westonb/cute-qcw/README.md

# cute-qcw
A compact qcw tesla coil system with a FPGA based controller. System design and construction are in progress. Build photos viewable here: https://www.flickr.com/photos/63341195@N08/sets/72157678478822788/
