westonb/cute-qcw/schematic/controller.pdf

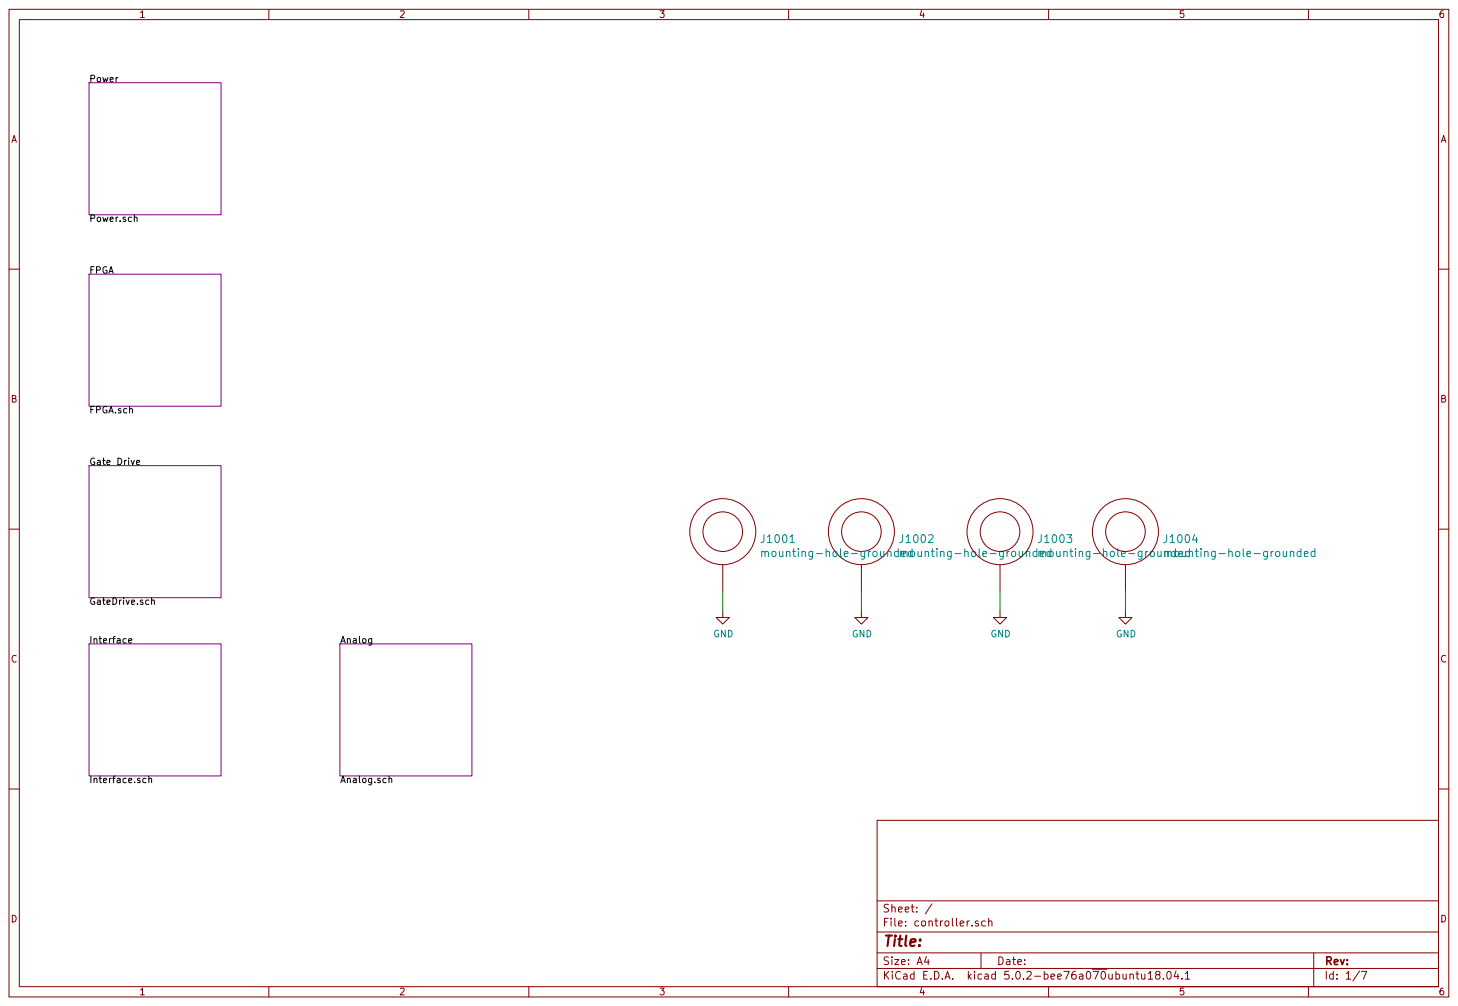
[picture p1: page 1]

Power Power.sch FPGA

FPGA.sch Gate Drive GateDrive.sch

Id: 1/7 Title: File: controller.sch Sheet: /

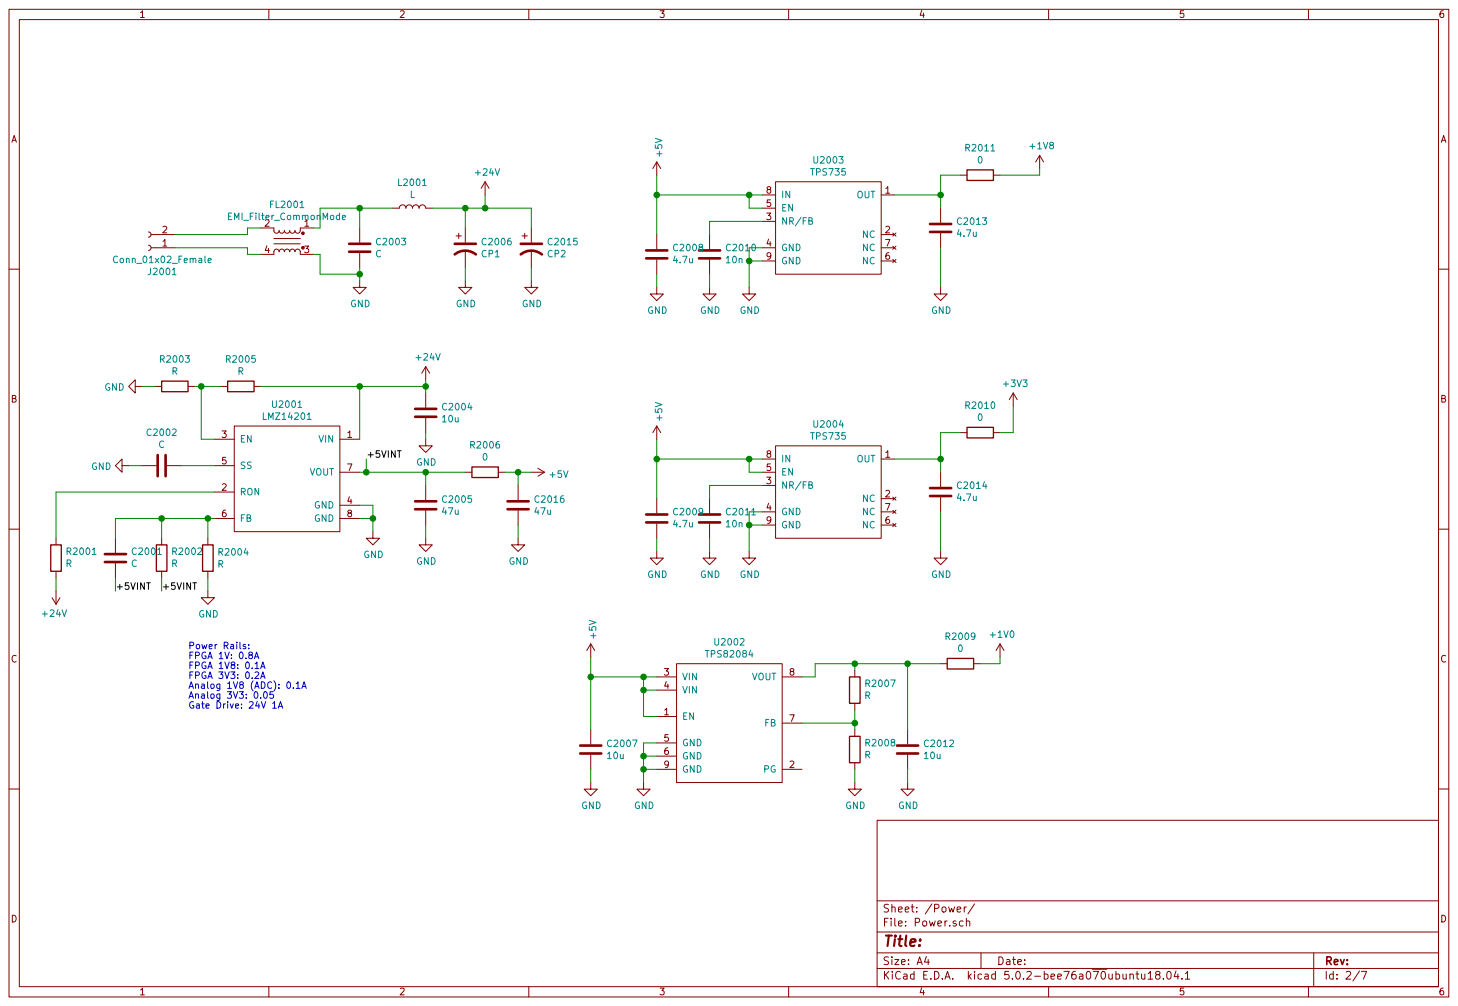
[picture p2: page 2]

Id: 2/7 Title: File: Power.sch Sheet: /Power/

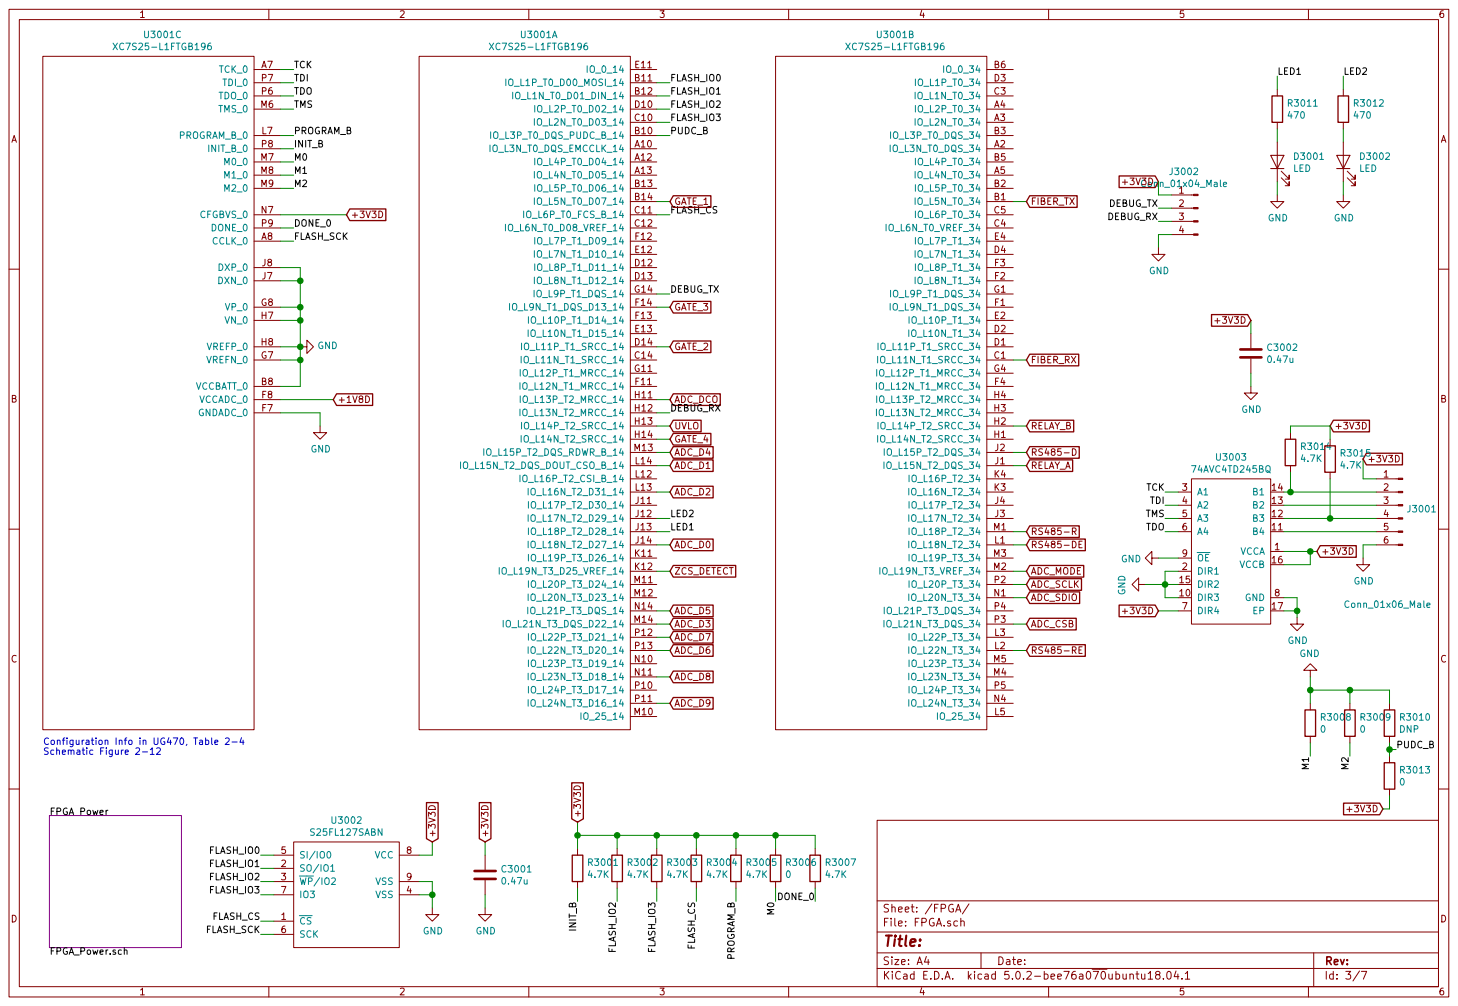
[picture p3: page 3]

Configuration Info in UG470, Table 2-4

Id: 3/7 Title: File: FPGA.sch Sheet: /FPGA/ FPGA Power FPGA_Power.sch

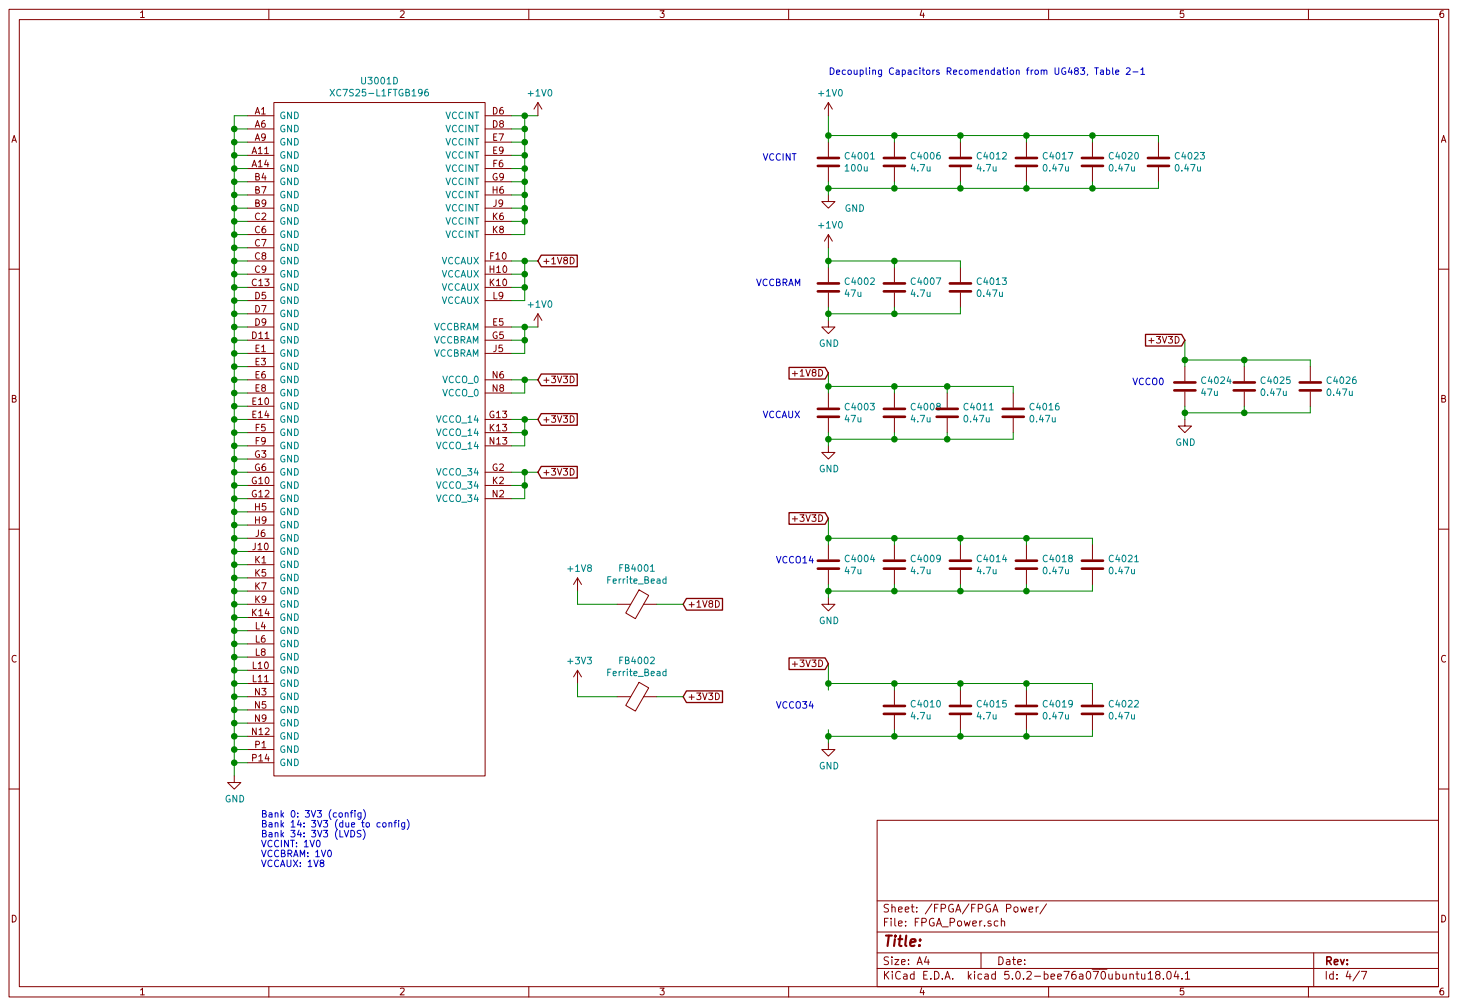
[picture p4: page 4]

Bank 14: 3V3 (due to config)
Bank 34: 3V3 (LVDS) VCCINT: 1V0 VCCBRAM: 1V0 VCCAUX: 1V8

File: FPGA_Power.sch Sheet: /FPGA/FPGA Power/

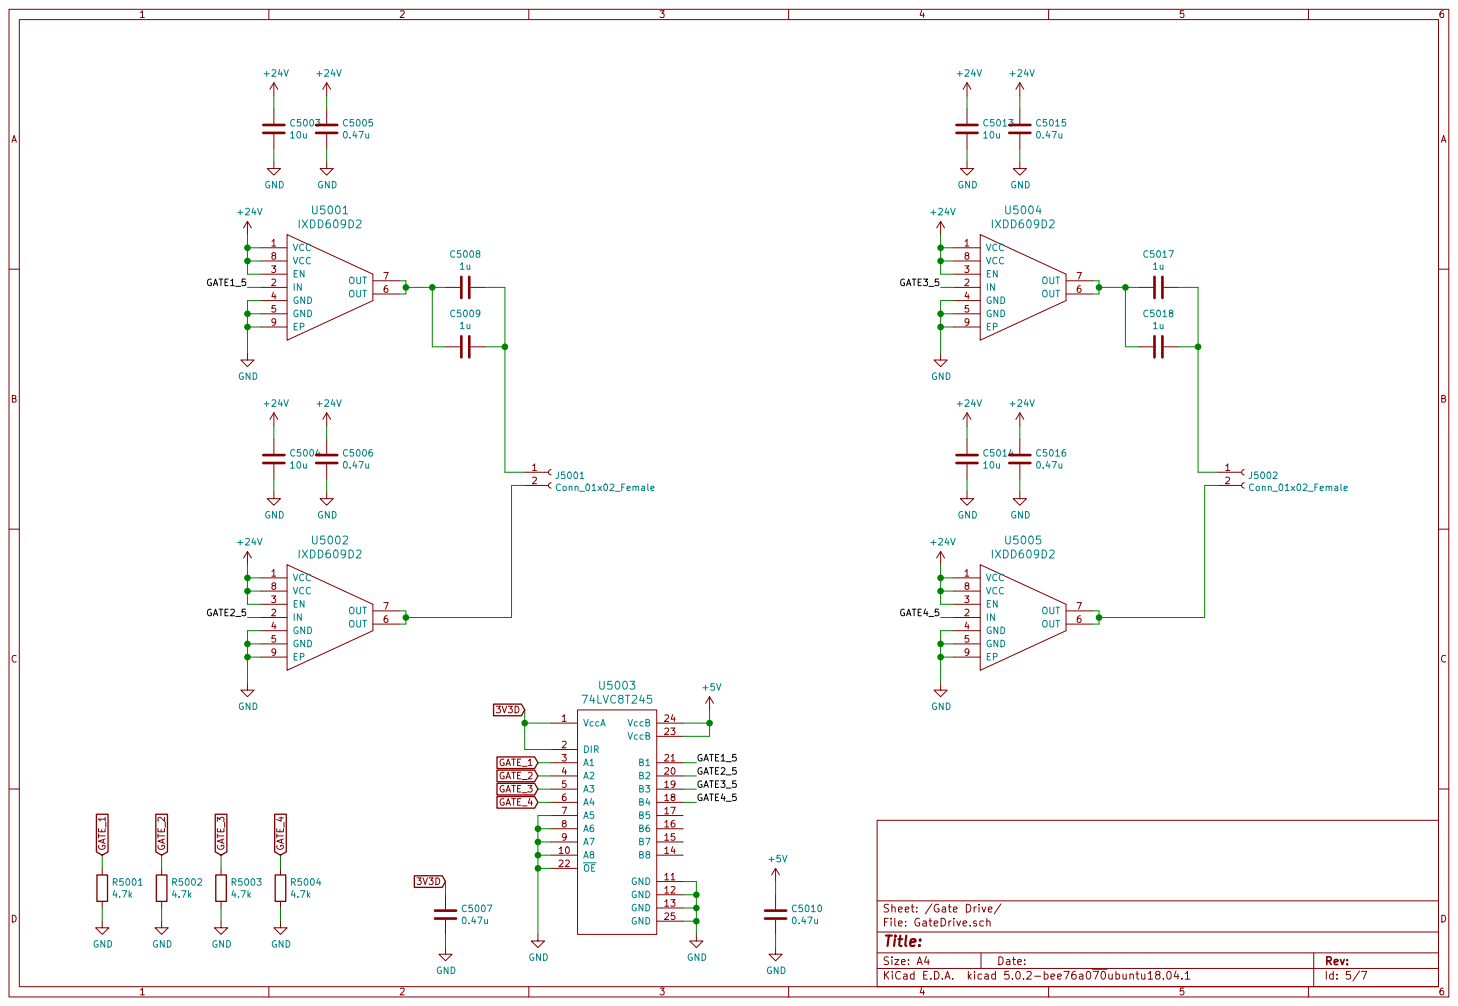
[picture p5: page 5]

Id: 5/7 Title: File: GateDrive.sch Sheet: /Gate Drive/

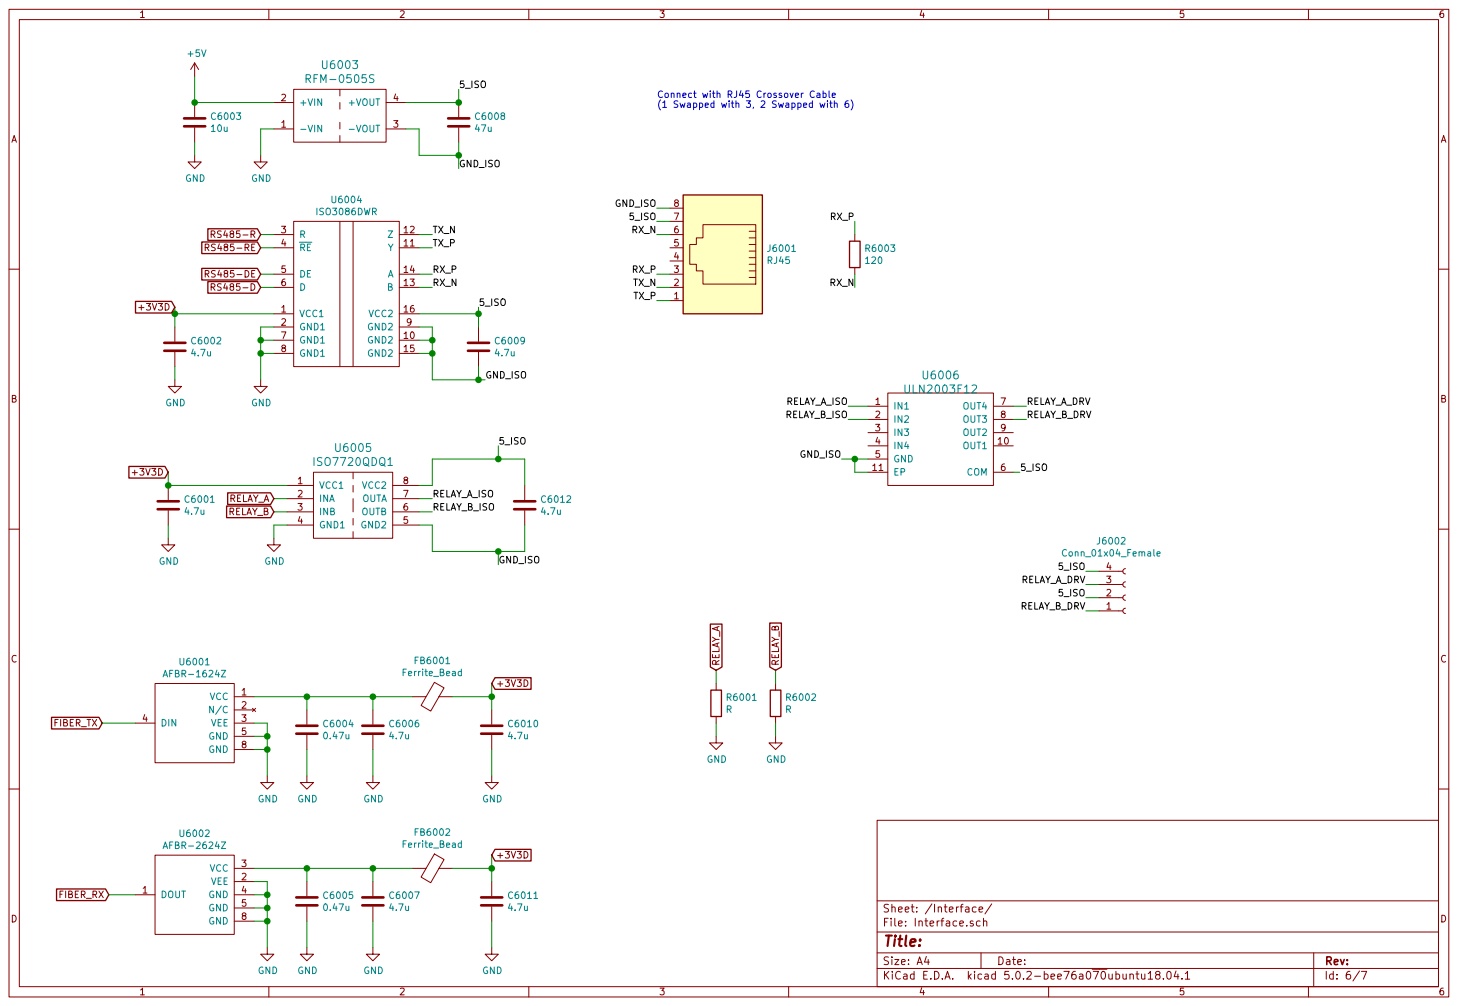
[picture p6: page 6]

J6002 Conn_01x04_Female Connect with RJ45 Crossover Cable
(1 Swapped with 3, 2 Swapped with 6) TX_P

Id: 6/7 Title: File: Interface.sch Sheet: /Interface/

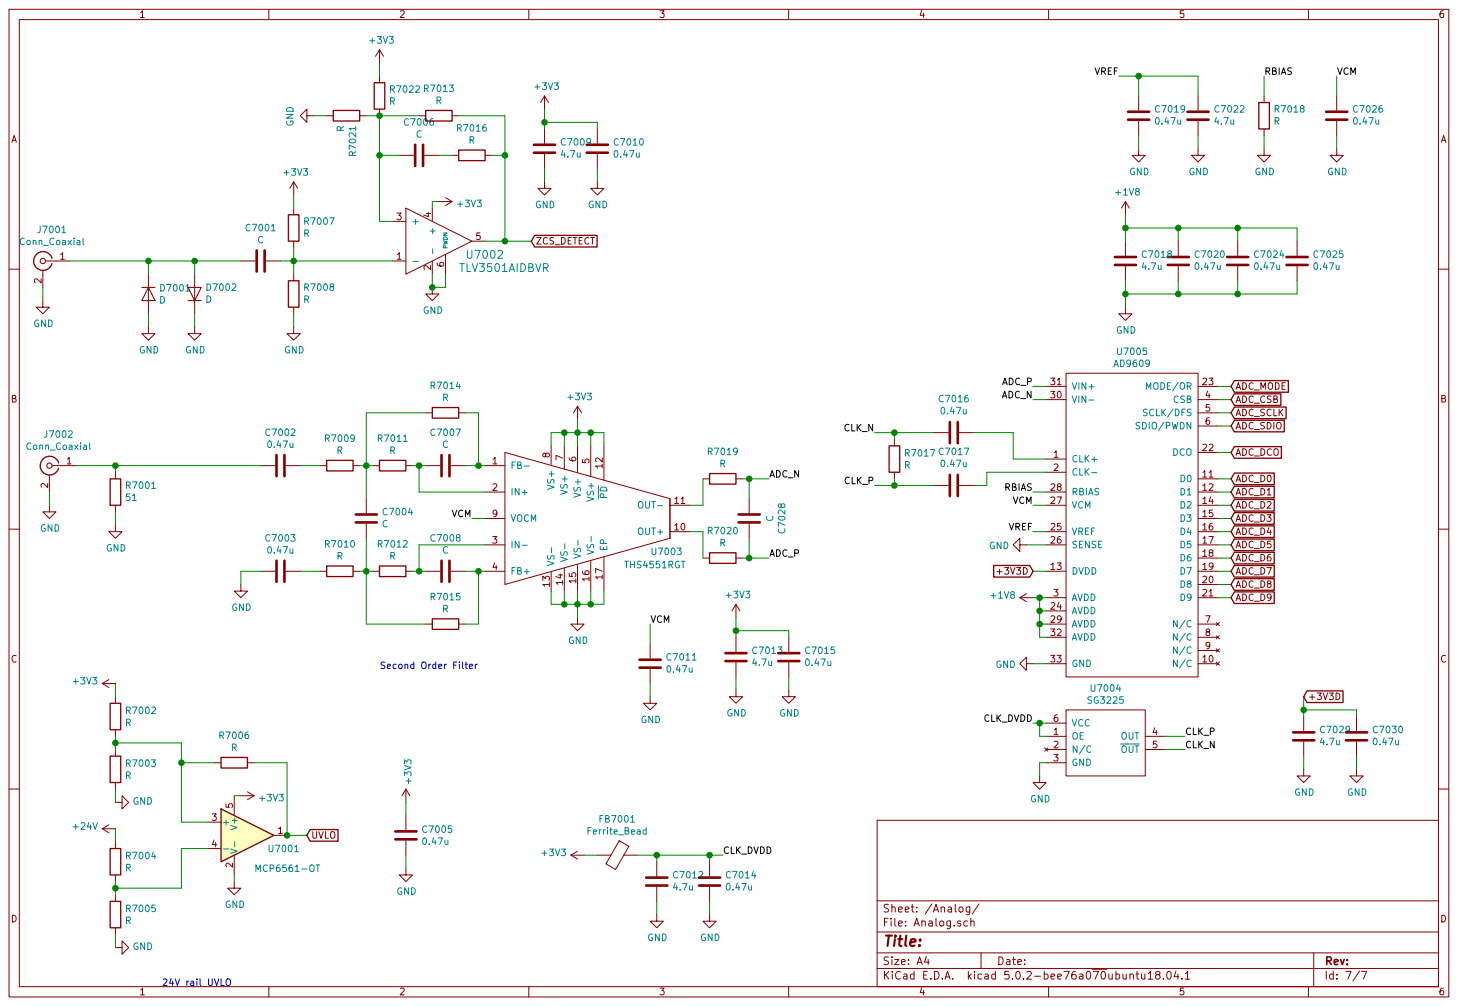
[picture p7: page 7]
