westonb/cute-qcw/schematic/mmc.pdf

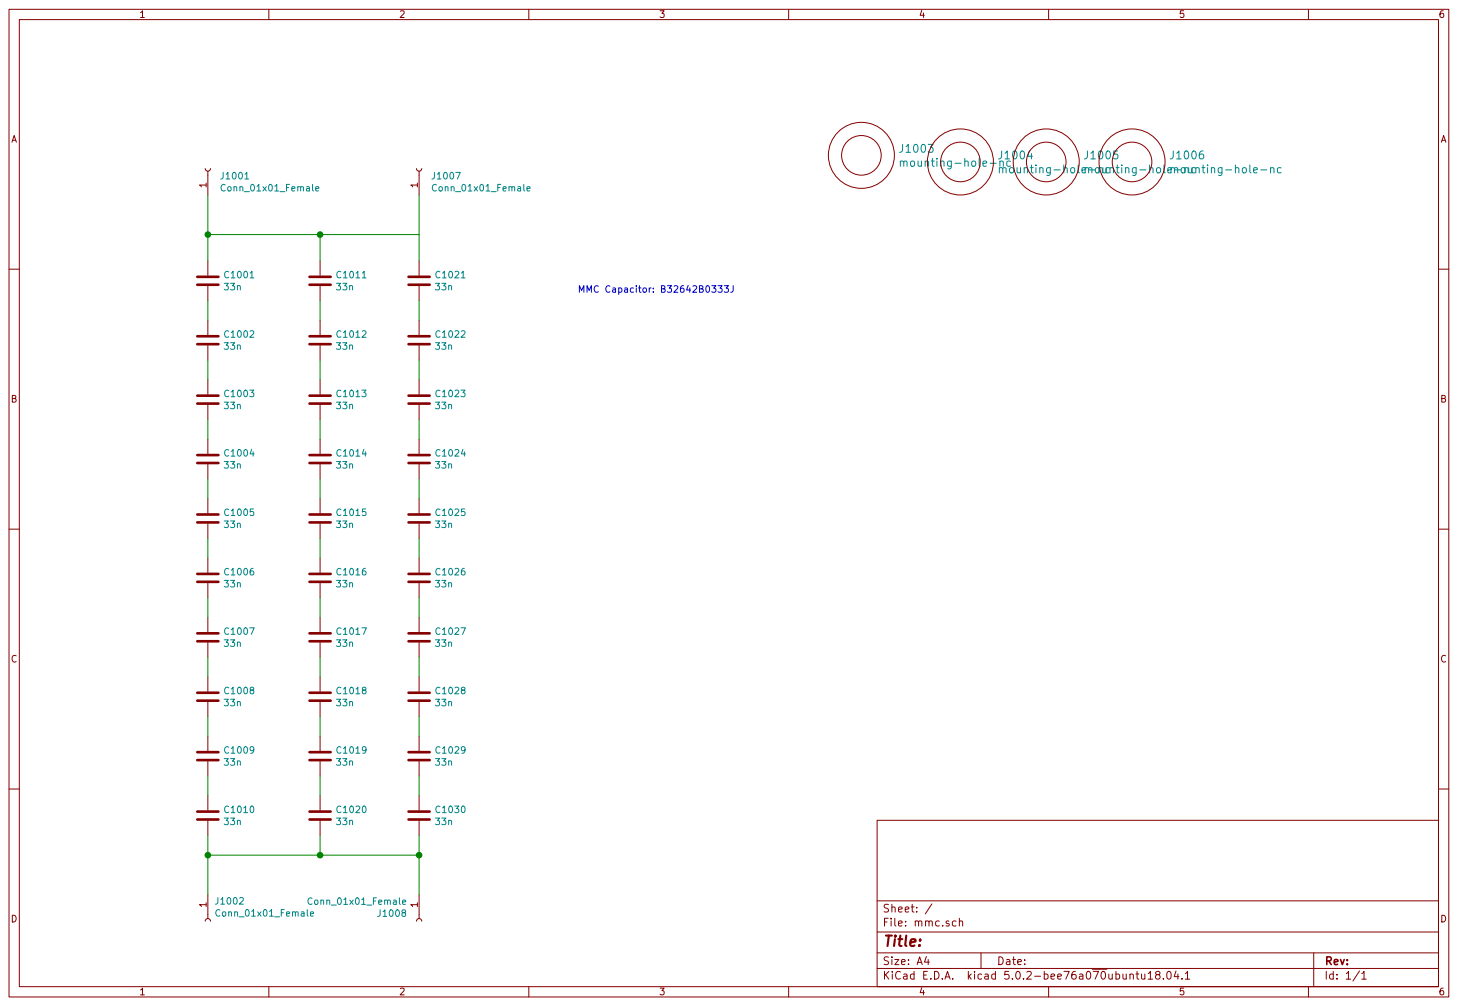
[picture p8: page 1]

J1003 mounting-hole-nc J1004 mounting-hole-nc

Id: 1/1 Title: File: mmc.sch Sheet: /
