westonb/cute-qcw/schematic/power.pdf

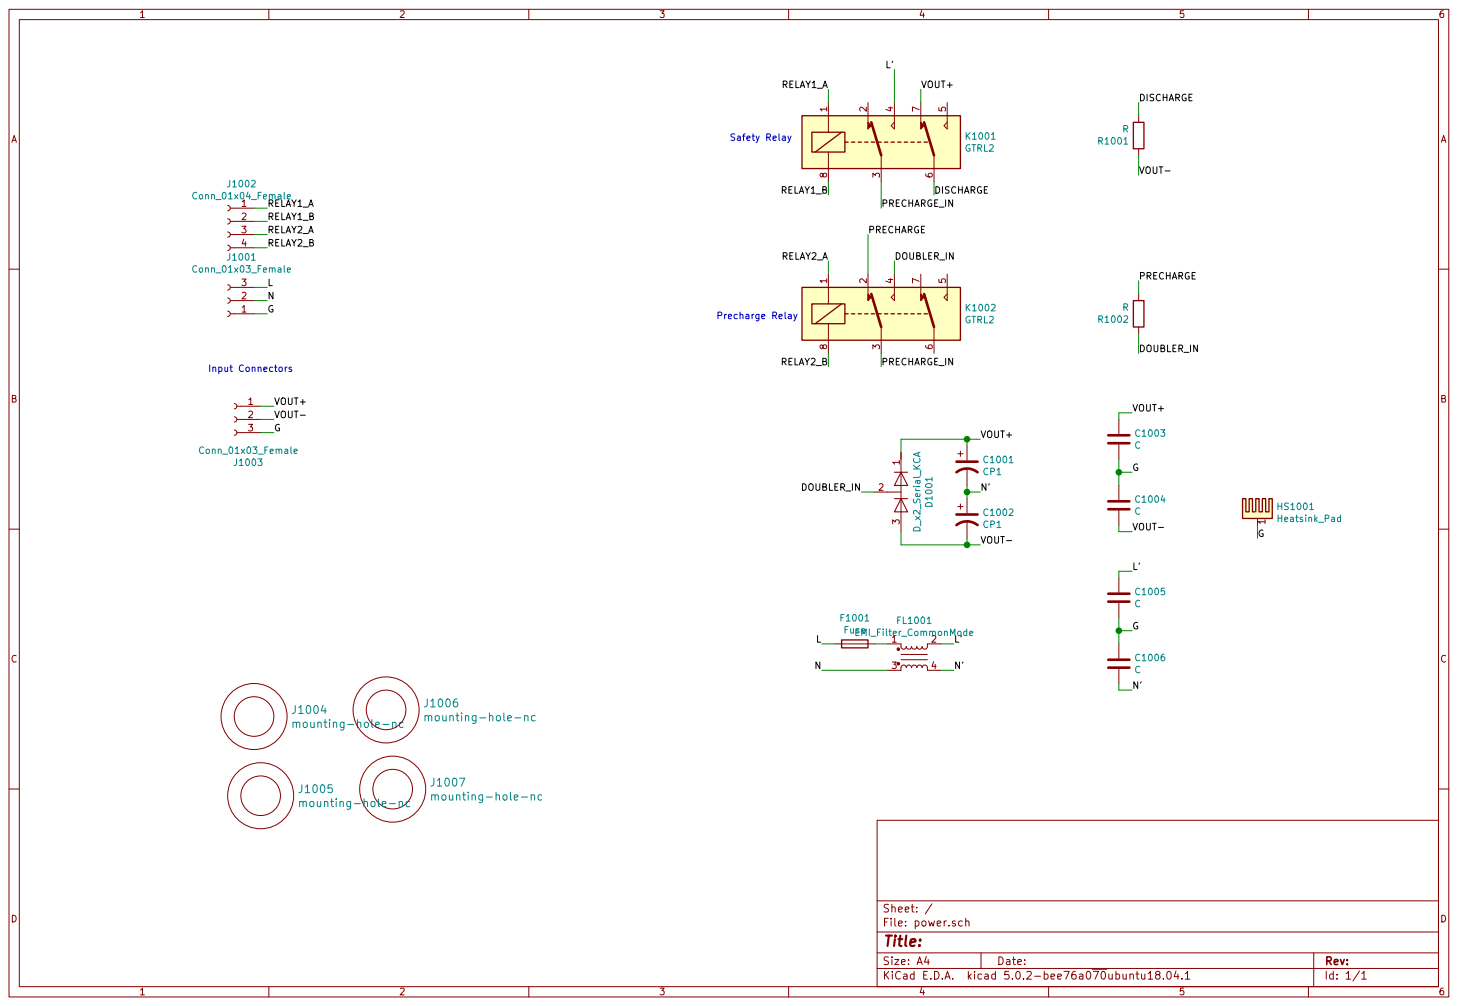
[picture p9: page 1]

File: power.sch Sheet: /
Id: 1/1 Title:
