westonb/cute-qcw/schematic/inverter.pdf

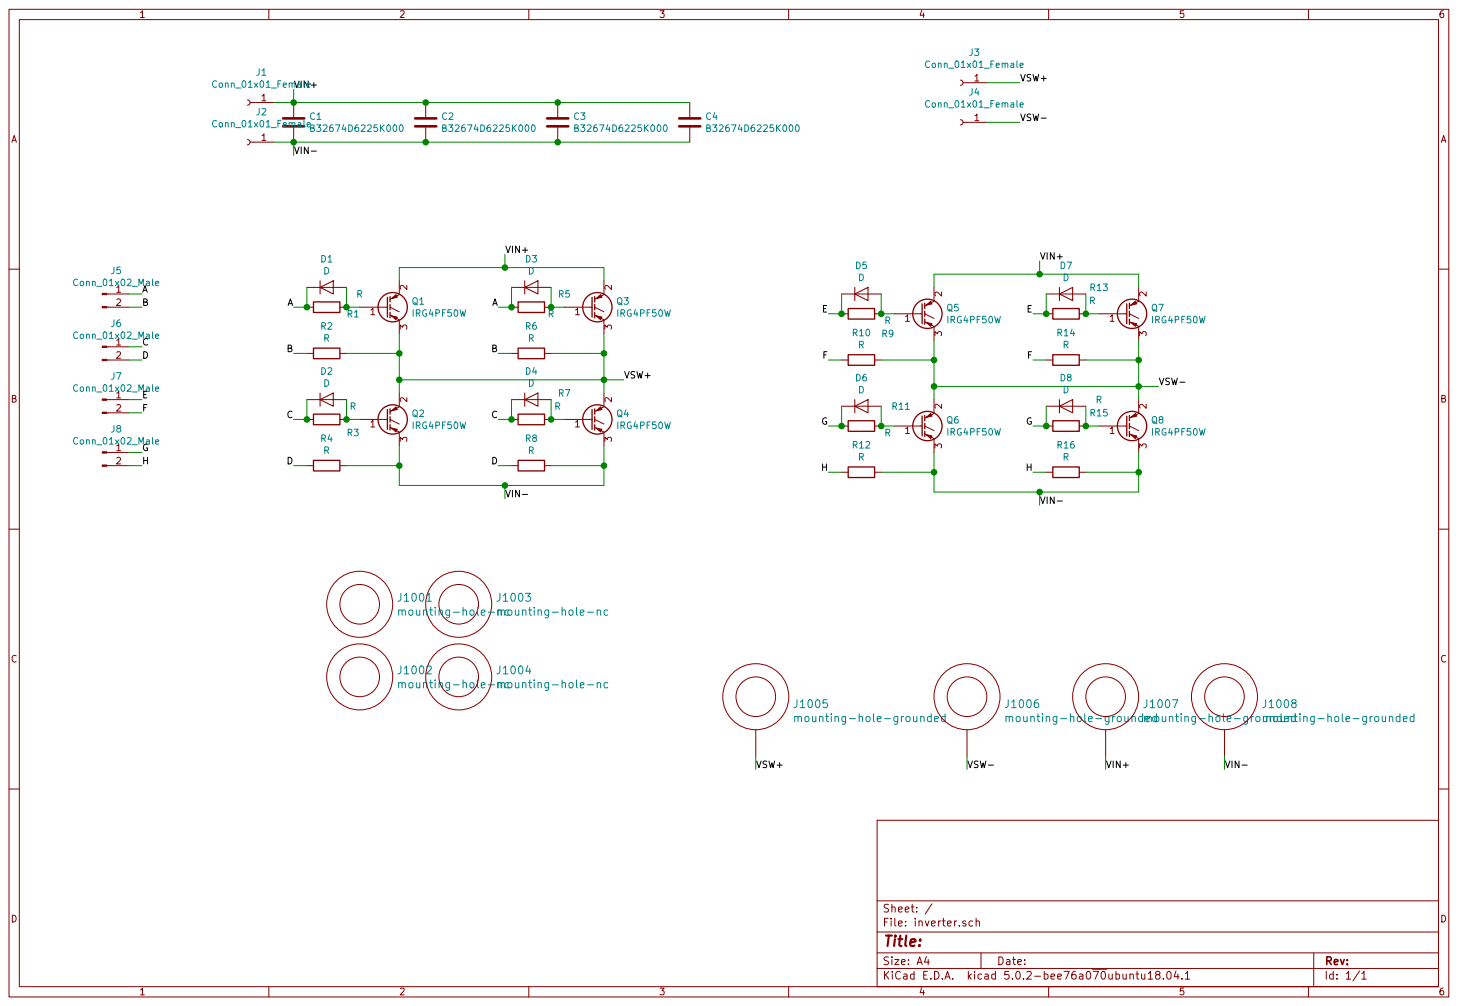
[picture p10: page 1]

Id: 1/1 Title: File: inverter.sch Sheet: /
