westonb/cute-qcw/simulation/inverter.asc

C1: cap; 3.3µ; Rser=12.4m Lser=21n
C2: cap; 3.3µ; Rser=12.4m Lser=21n
C3: cap; 4.7µ
C4: cap; 3.3µ; Rser=12.4m Lser=21n
C5: cap; 3.3µ; Rser=12.4m Lser=21n
C6: cap; 4.7µ
C7: cap; 10n
L1: ind; 1n
L2: ind; 1n
L3: ind; 1n
L4: ind; 1n
L5: ind2; 20µ
L6: ind2; 20µ
L7: ind; 1n
L8: ind; 1n
L9: ind; 1n
L10: ind; 1n
L11: ind; 1n
L12: ind2; 20µ
L13: ind; 1n
L14: ind; 1n
L15: ind; 1n
L16: ind; 1n
L17: ind2; 20µ
L18: ind2; 20µ
L19: ind; 1n
L20: ind; 1n
L21: ind; 1n
L22: ind; 1n
L23: ind; 1n
L24: ind2; 20µ
L25: ind; 1n
L26: ind; 1n
L27: ind; 15.8µ
R1: res; 0.5
R2: res; 0.5
R3: res; 0.5
R4: res; 0.5
R5: res; 0.5
R6: res; 0.5
R7: res; 0.5
R8: res; 0.5
R9: res; 0.1
R10: res; 0.5
R11: res; 0.5
R12: res; 0.5
R13: res; 0.5
R14: res; 0.5
R15: res; 0.5
R16: res; 0.5
R17: res; 0.5
R18: res; 0.1
R19: res; 2.5
U1: FGA40T65UQDF_3P
U2: FGA40T65UQDF_3P
U3: FGA40T65UQDF_3P
U4: FGA40T65UQDF_3P
U5: FGA40T65UQDF_3P
U6: FGA40T65UQDF_3P
U7: FGA40T65UQDF_3P
U8: FGA40T65UQDF_3P
V1: voltage; PULSE(0 16 0 10n 10n {PERIOD*DUTY} {PERIOD})
V2: voltage; PULSE(0 16 {0.5*PERIOD} 10n 10n {PERIOD*DUTY} {PERIOD})
V3: voltage; PULSE(0 16 {PHASE*PERIOD/360} 10n 10n {PERIOD*DUTY} {PERIOD})
V4: voltage; PULSE(0 16 {PHASE*PERIOD/360+0.5*PERIOD} 10n 10n {PERIOD*DUTY} {PERIOD})
V5: voltage; 200; Rser=0.5
Named nets: 0, GD_1A, GD_1B, GD_2A, GD_2B, GD_3A, GD_3B, GD_4A, GD_4B, OUT_A, OUT_B
K1 L5 L6 L12 1
.param FREQ 400E3
.param PERIOD {1/FREQ}
.param DUTY=0.45
.param PHASE=90
K2 L24 L17 L18 1
.tran 0 {200*PERIOD} 0
,LIB ONSEMI_IGBT_FS4FGA40T65UQDF_REV0fe2_ltspice.txt
.ic V(n003) = 200
.ic V(n002) = 200
.ic V(n004) = 200
.ic V(n005) = 200
