westonb/cute-qcw/simulation/inverter_mismatch.asc

C1: cap; 400p; Rser=500m
C2: cap; 400p; Rser=500m
C3: cap; 400p; Rser=500m
C4: cap; 400p; Rser=500m
C5: cap; 400p; Rser=500m
C6: cap; 400p; Rser=500m
C7: cap; 9.9n
D1: diode; D_PWR
D2: diode; D_PWR
D3: diode; D_PWR
D4: diode; D_PWR
D5: diode; D_PWR
D6: diode; D_PWR
L1: ind; 10n; Rser=10m
L2: ind; 100n
L3: ind; 10n; Rser=10m
L4: ind; 10n; Rser=10m
L5: ind; 10n; Rser=10m
L6: ind; 100n
L10: ind; {L11}
L11: ind; {l12}
L12: ind; {l13}
L13: ind2; {l23}
L14: ind2; 1
L15: ind2; 1
L16: ind2; {1*n3*n3}
L17: ind2; {1*n2*n2}
L18: ind; 10n; Rser=10m
L19: ind; 10n; Rser=10m
L20: ind; 100n
L27: ind; 15.8µ
R19: res; 2.5
S1: sw; SW_PWR
S2: sw; SW_PWR
S3: sw; SW_PWR
S4: sw; SW_PWR
S5: sw; SW_PWR
S6: sw; SW_PWR
V1: voltage; PULSE(-20 20 {1.5*PERIOD+MISMATCH} {TRISE} {TFALL} {PERIOD*DUTY} {PERIOD})
V2: voltage; PULSE(-20 20 {PERIOD} {TRISE} {TFALL} {PERIOD*DUTY} {PERIOD})
V3: voltage; PULSE(-20 20 {PERIOD} {TRISE} {TFALL} {PERIOD*DUTY} {PERIOD})
V4: voltage; PULSE(-20 20 {PERIOD+MISMATCH} {TRISE} {TFALL} {PERIOD*DUTY} {PERIOD})
V5: voltage; PULSE(-20 20 {1.5*PERIOD} {TRISE} {TFALL} {PERIOD*DUTY} {PERIOD})
V6: voltage; PULSE(-20 20 {1.5*PERIOD} {TRISE} {TFALL} {PERIOD*DUTY} {PERIOD})
V7: voltage; 200; Rser=0.01
V8: voltage; 200; Rser=0.01
V9: voltage; 200; Rser=0.01
Named nets: 0, VSW1, VSW2, 1A, 1B, 2A, 2B, 3A, 3B
.param FREQ 400E3
.param PERIOD {1/FREQ}
.param DUTY=0.45
.param TFALL 40n
.param TRISE 40n
.param MISMATCH=0.1n
.tran 0 {20*PERIOD} {PERIOD}
.model SW_PWR SW(Ron = 0.05 Roff=1Meg Vt=0 Vh=-10)
.model D_PWR D(Ron=10m Roff=1Meg Vfwd=0.7)m
.param L11 5.4E-6
.param n2 {5.1E-6/L11}
.param n3 {2.6E-7/L11}
.param l12 {1/(1*n2*11039)}
.param l13 {1/(1*n3*19890)}
.param l23 {-1/(n2*n3*11039)}
K1 L14 L17 1
K2 L15 L16 1
