westonb/cute-qcw/pcb/controller/controller.kicad_pcb

## KiCad design pcb/controller/controller.kicad_pcb (2019-02-12)

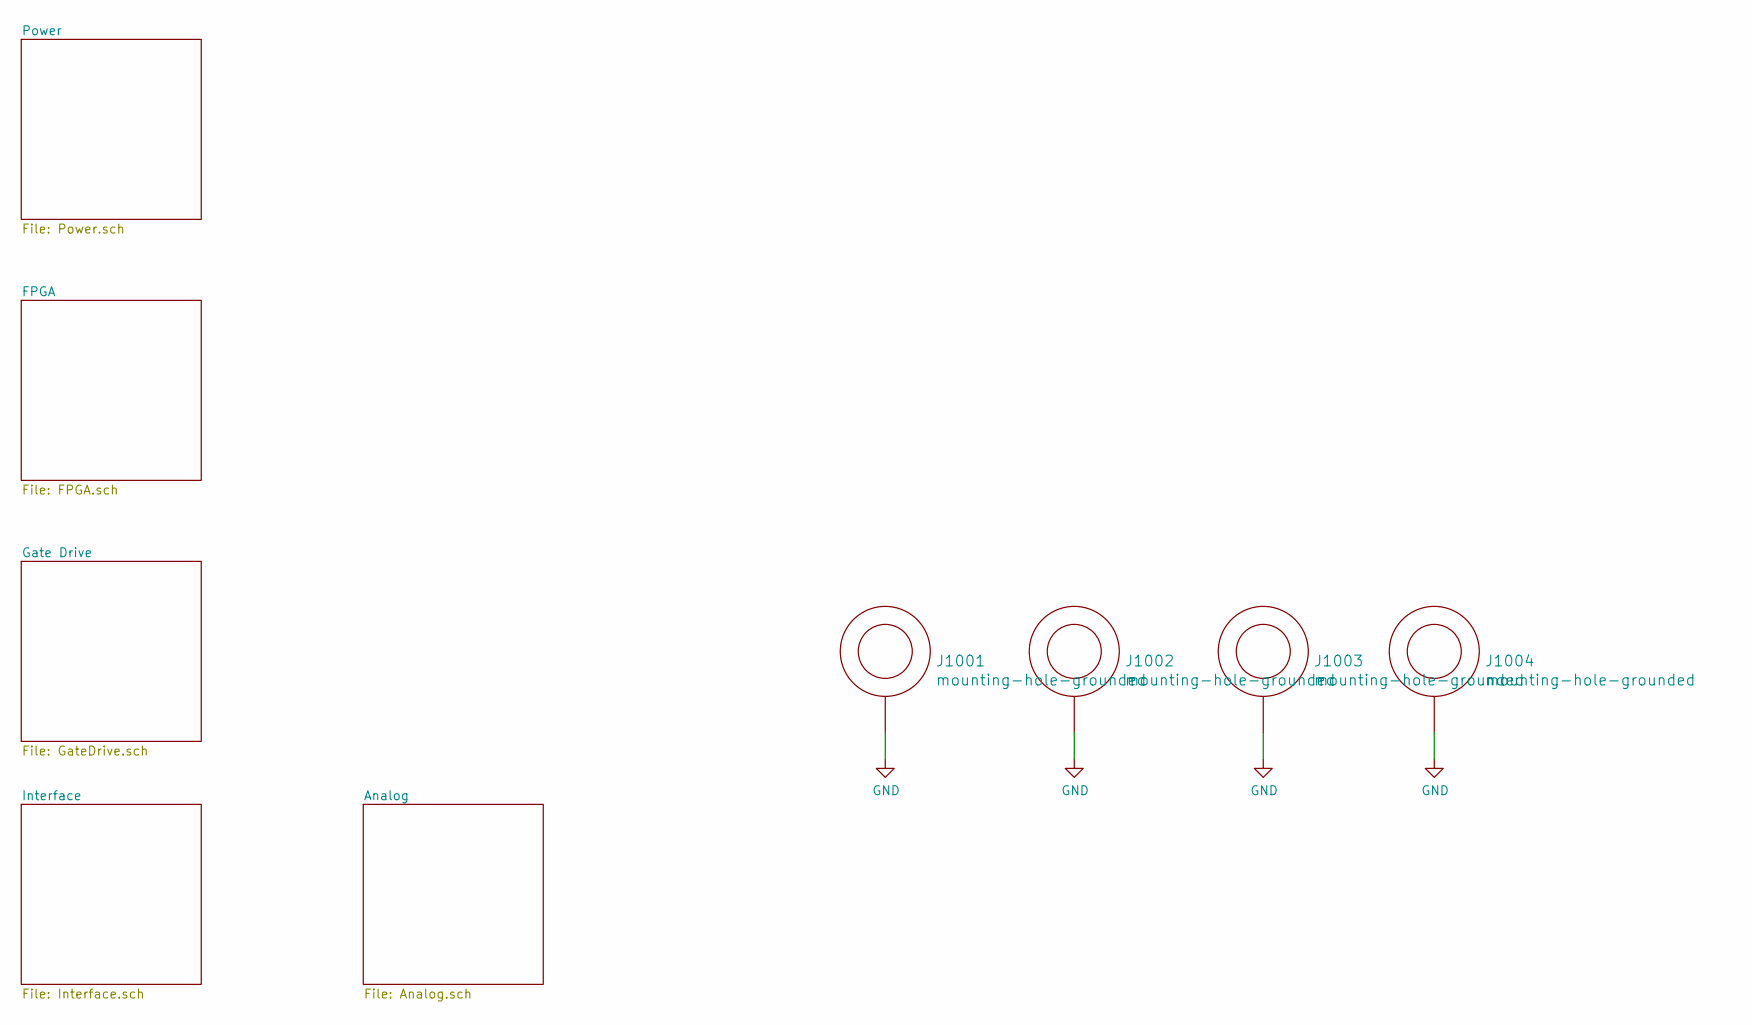
[picture p11: schematic controller.sch]

Parts:
J1001, J1002, J1003, J1004: mounting-hole-grounded; M3-tight-fit-pan-head

Connections:
GND: J1001.1, J1002.1, J1003.1, J1004.1; also elsewhere on the board

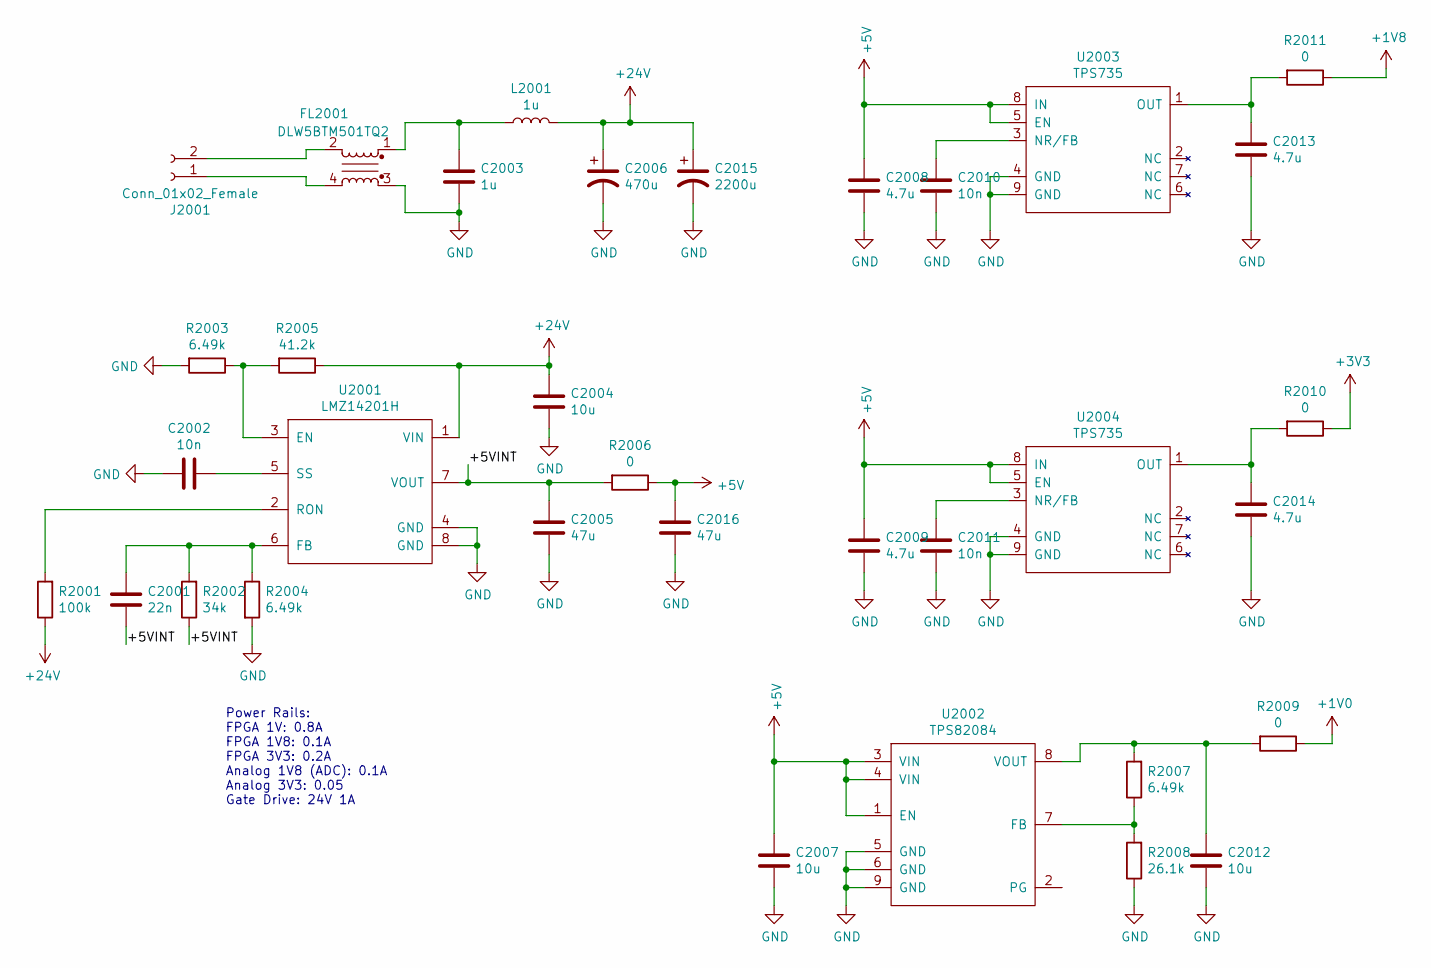
[picture p12: schematic Power.sch]

Parts:
C2001: 22n; C_0402_1005Metric
C2002, C2010, C2011: 10n; C_0402_1005Metric
C2003: 1u; C_0805_2012Metric
C2004: 10u; C_1206_3216Metric
C2005, C2016: 47u; C_0805_2012Metric
C2006: 470u; CP_Radial_D10.0mm_P5.00mm
C2007, C2012: 10u; C_0805_2012Metric
C2008, C2009, C2013, C2014: 4.7u; C_0402_1005Metric
C2015: 2200u; CAP_16mmx37mm_horizontal
FL2001: DLW5BTM501TQ2; DLW5BTM
J2001: Conn_01x02_Female; Terminal-block-plug_2x1_3.5mm-pitch
L2001: 1u; L_Vishay_IHLP-1212
R2001: 100k; R_0402_1005Metric
R2002: 34k; R_0402_1005Metric
R2003, R2004, R2007: 6.49k; R_0402_1005Metric
R2005: 41.2k; R_0402_1005Metric
R2006, R2009, R2010, R2011: 0; R_0805_2012Metric
R2008: 26.1k; R_0402_1005Metric
U2001: LMZ14201H; TO-PMOD-7
U2002: TPS82084; uSil-8
U2003, U2004: TPS735; SON-8_EP

Connections:
+1V0: R2009.1; also elsewhere on the board
+1V8: R2011.1; also elsewhere on the board
+3V3: R2010.1; also elsewhere on the board
+5V: C2007.1, C2008.2, C2009.2, C2016.1, R2006.1, U2002.1 (EN), U2002.3 (VIN), U2002.4 (VIN), U2003.5 (EN), U2003.8 (IN), U2004.5 (EN), U2004.8 (IN); also elsewhere on the board
+24V: C2004.1, C2006.1, C2015.1, L2001.2, R2001.1, R2005.1, U2001.1 (VIN); also elsewhere on the board
/Power/+5VINT: C2001.1, C2005.1, R2002.1, R2006.2, U2001.7 (VOUT)
GND: C2002.2, C2003.2, C2004.2, C2005.2, C2006.2, C2007.2, C2008.1, C2009.1, C2010.1, C2011.1, C2012.2, C2013.1, C2014.1, C2015.2, C2016.2, FL2001.3, R2003.2, R2004.2, R2008.1, U2001.4 (GND), U2001.8 (GND), U2002.5 (GND), U2002.6 (GND), U2002.9 (GND), U2003.4 (GND), U2003.9 (GND), U2004.4 (GND), U2004.9 (GND); also elsewhere on the board
unnamed: C2001.2, R2002.2, R2004.1, U2001.6 (FB)
unnamed: C2002.1, U2001.5 (SS)
unnamed: C2003.1, FL2001.1, L2001.1
unnamed: C2010.2, U2003.3 (NR/FB)
unnamed: C2011.2, U2004.3 (NR/FB)
unnamed: C2012.1, R2007.2, R2009.2, U2002.8 (VOUT)
unnamed: C2013.2, R2011.2, U2003.1 (OUT)
unnamed: C2014.2, R2010.2, U2004.1 (OUT)
unnamed: FL2001.2, J2001.2
unnamed: FL2001.4, J2001.1
unnamed: R2001.2, U2001.2 (RON)
unnamed: R2003.1, R2005.2, U2001.3 (EN)
unnamed: R2007.1, R2008.2, U2002.7 (FB)

Notes on the sheet:
Power Rails: FPGA 1V: 0.8A FPGA 1V8: 0.1A FPGA 3V3: 0.2A Analog 1V8 (ADC): 0.1A Analog 3V3: 0.05 Gate Drive: 24V 1A

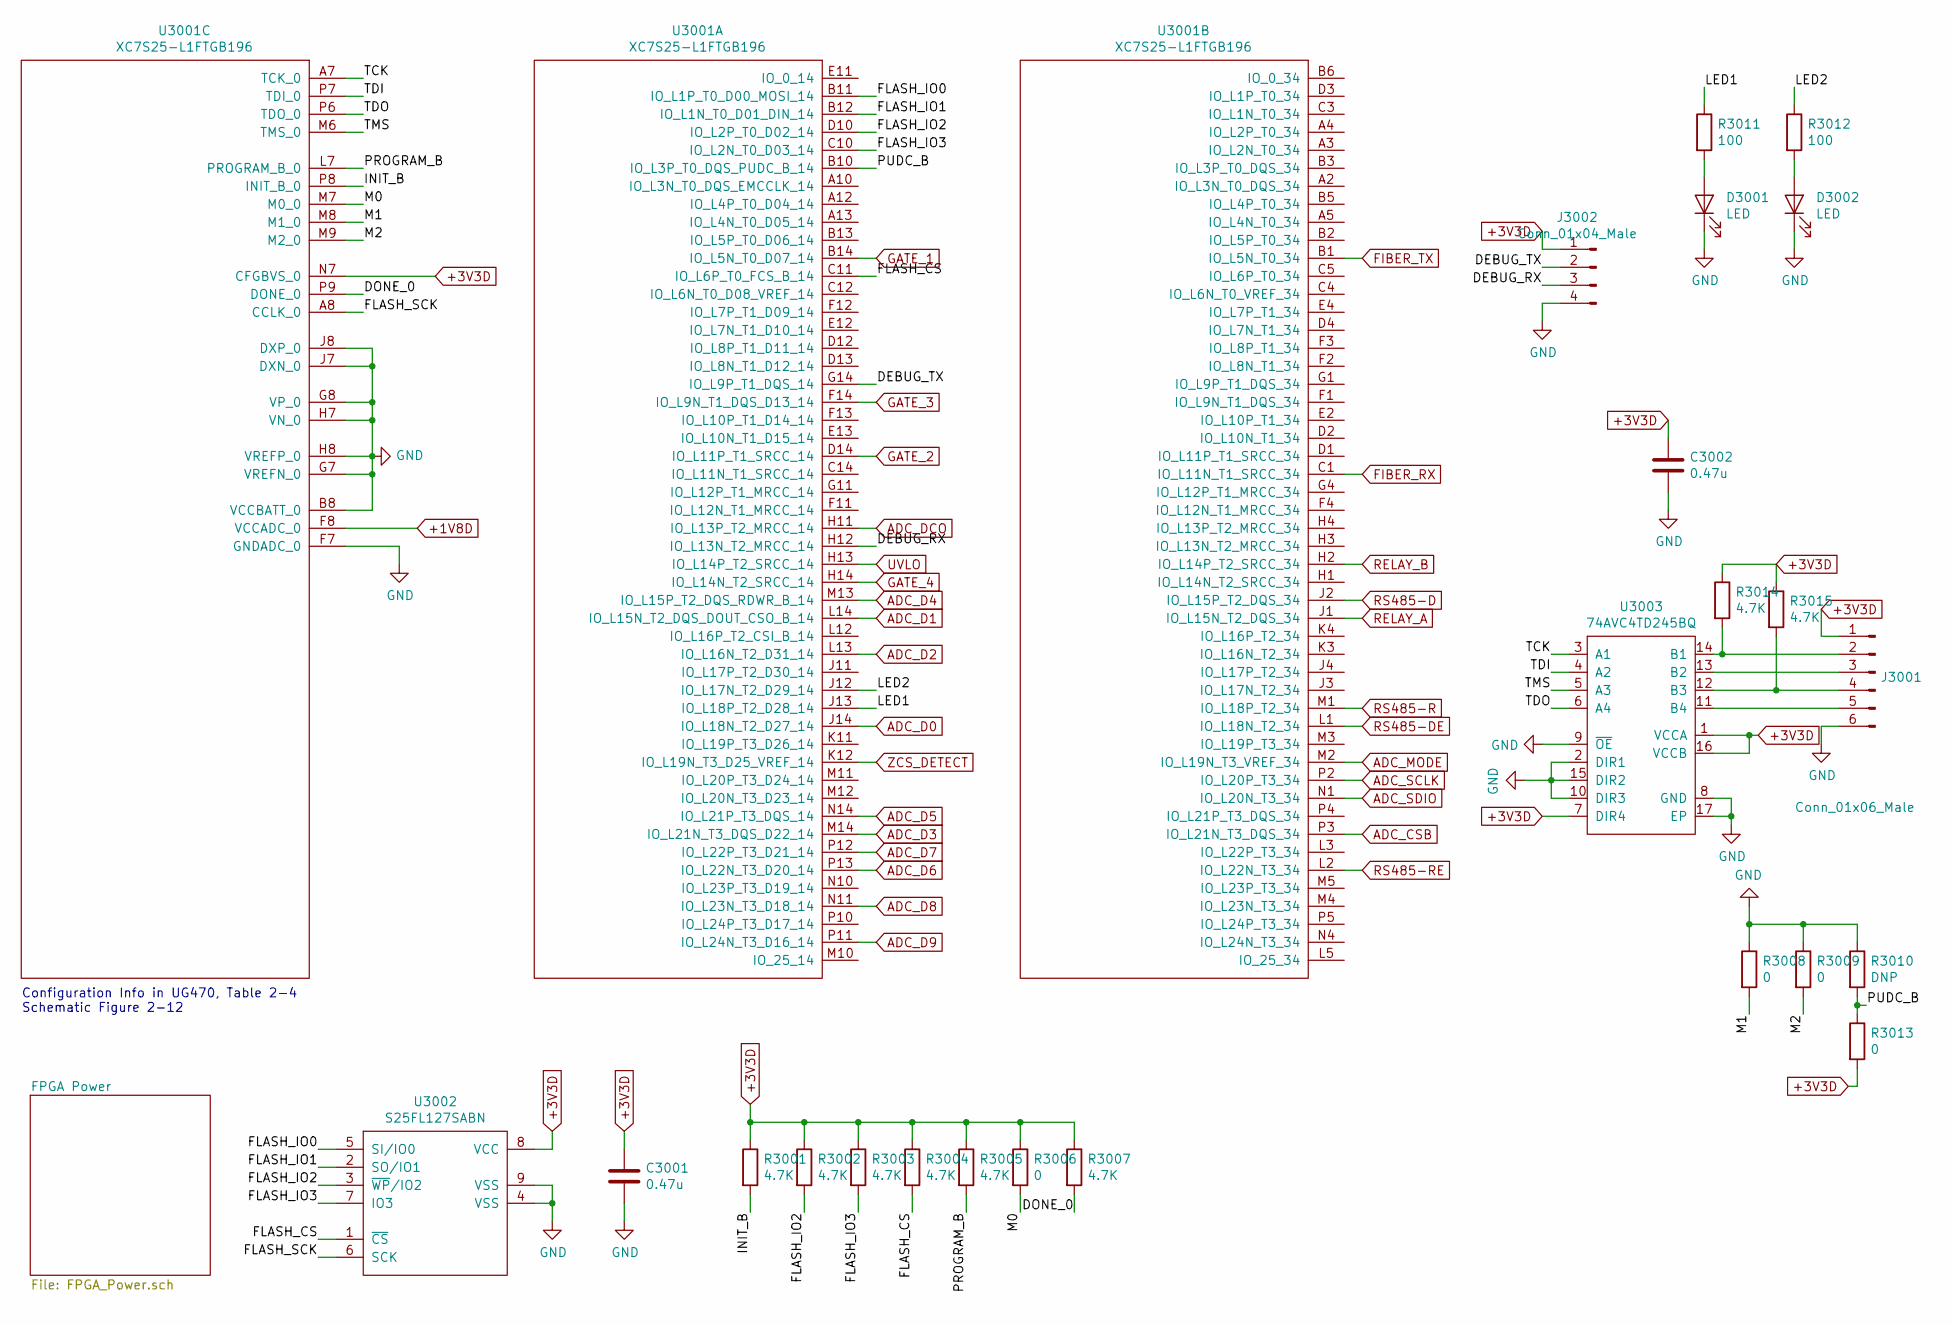
[picture p13: schematic FPGA.sch]

Parts:
C3001, C3002: 0.47u; C_0402_1005Metric
D3001, D3002: LED; LED-T1-RIGHT-ANGLE_4.6x4.4mm
J3001: Conn_01x06_Male; PinHeader_1x06_P2.54mm_Vertical
J3002: Conn_01x04_Male; PinHeader_1x04_P2.54mm_Vertical
R3001, R3002, R3003, R3004, R3005, R3007, R3014, R3015: 4.7K; R_0402_1005Metric
R3006, R3008, R3009, R3013: 0; R_0402_1005Metric
R3010: DNP; R_0402_1005Metric
R3011, R3012: 100; R_0402_1005Metric
U3001: XC7S25-L1FTGB196; FTGB196
U3002: S25FL127SABN; WSON-8-1EP_6x5mm_P1.27mm_EP3.4x4mm
U3003: 74AVC4TD245BQ; DHVQFN16

Connections:
+1V8D: U3001.F8 (VCCADC_0); also elsewhere on the board
+3V3D: C3001.1, C3002.1, J3001.1, J3002.1, R3001.1, R3002.1, R3003.1, R3004.1, R3005.1, R3006.1, R3007.1, R3013.2, R3014.1, R3015.1, U3001.N7 (CFGBVS_0), U3002.8 (VCC), U3003.1 (VCCA), U3003.7 (DIR4), U3003.16 (VCCB); also elsewhere on the board
/FPGA/DEBUG_RX: J3002.3, U3001.H12 (IO_L13N_T2_MRCC_14)
/FPGA/DEBUG_TX: J3002.2, U3001.G14 (IO_L9P_T1_DQS_14)
/FPGA/DONE_0: R3007.2, U3001.P9 (DONE_0)
/FPGA/FLASH_CS: R3004.2, U3001.C11 (IO_L6P_T0_FCS_B_14), U3002.1 (~CS)
/FPGA/FLASH_IO0: U3001.B11 (IO_L1P_T0_D00_MOSI_14), U3002.5 (SI/IO0)
/FPGA/FLASH_IO1: U3001.B12 (IO_L1N_T0_D01_DIN_14), U3002.2 (SO/IO1)
/FPGA/FLASH_IO2: R3002.2, U3001.D10 (IO_L2P_T0_D02_14), U3002.3 (~WP~/IO2)
/FPGA/FLASH_IO3: R3003.2, U3001.C10 (IO_L2N_T0_D03_14), U3002.7 (IO3)
/FPGA/FLASH_SCK: U3001.A8 (CCLK_0), U3002.6 (SCK)
/FPGA/INIT_B: R3001.2, U3001.P8 (INIT_B_0)
/FPGA/LED1: R3011.1, U3001.J13 (IO_L18P_T2_D28_14)
/FPGA/LED2: R3012.1, U3001.J12 (IO_L17N_T2_D29_14)
/FPGA/M0: R3006.2, U3001.M7 (M0_0)
/FPGA/M1: R3008.2, U3001.M8 (M1_0)
/FPGA/M2: R3009.2, U3001.M9 (M2_0)
/FPGA/PROGRAM_B: R3005.2, U3001.L7 (PROGRAM_B_0)
/FPGA/PUDC_B: R3010.2, R3013.1, U3001.B10 (IO_L3P_T0_DQS_PUDC_B_14)
/FPGA/TCK: U3001.A7 (TCK_0), U3003.3 (A1)
/FPGA/TDI: U3001.P7 (TDI_0), U3003.4 (A2)
/FPGA/TDO: U3001.P6 (TDO_0), U3003.6 (A4)
/FPGA/TMS: U3001.M6 (TMS_0), U3003.5 (A3)
ADC_CSB: U3001.P3 (IO_L21N_T3_DQS_34); also elsewhere on the board
ADC_D0: U3001.J14 (IO_L18N_T2_D27_14); also elsewhere on the board
ADC_D1: U3001.L14 (IO_L15N_T2_DQS_DOUT_CSO_B_14); also elsewhere on the board
ADC_D2: U3001.L13 (IO_L16N_T2_D31_14); also elsewhere on the board
ADC_D3: U3001.M14 (IO_L21N_T3_DQS_D22_14); also elsewhere on the board
ADC_D4: U3001.M13 (IO_L15P_T2_DQS_RDWR_B_14); also elsewhere on the board
ADC_D5: U3001.N14 (IO_L21P_T3_DQS_14); also elsewhere on the board
ADC_D6: U3001.P13 (IO_L22N_T3_D20_14); also elsewhere on the board
ADC_D7: U3001.P12 (IO_L22P_T3_D21_14); also elsewhere on the board
ADC_D8: U3001.N11 (IO_L23N_T3_D18_14); also elsewhere on the board
ADC_D9: U3001.P11 (IO_L24N_T3_D16_14); also elsewhere on the board
ADC_DCO: U3001.H11 (IO_L13P_T2_MRCC_14); also elsewhere on the board
ADC_MODE: U3001.M2 (IO_L19N_T3_VREF_34); also elsewhere on the board
ADC_SCLK: U3001.P2 (IO_L20P_T3_34); also elsewhere on the board
ADC_SDIO: U3001.N1 (IO_L20N_T3_34); also elsewhere on the board
FIBER_RX: U3001.C1 (IO_L11N_T1_SRCC_34); also elsewhere on the board
FIBER_TX: U3001.B1 (IO_L5N_T0_34); also elsewhere on the board
GATE_1: U3001.B14 (IO_L5N_T0_D07_14); also elsewhere on the board
GATE_2: U3001.D14 (IO_L11P_T1_SRCC_14); also elsewhere on the board
GATE_3: U3001.F14 (IO_L9N_T1_DQS_D13_14); also elsewhere on the board
GATE_4: U3001.H14 (IO_L14N_T2_SRCC_14); also elsewhere on the board
GND: C3001.2, C3002.2, D3001.1 (K), D3002.1 (K), J3001.6, J3002.4, R3008.1, R3009.1, R3010.1, U3001.B8 (VCCBATT_0), U3001.F7 (GNDADC_0), U3001.G7 (VREFN_0), U3001.G8 (VP_0), U3001.H7 (VN_0), U3001.H8 (VREFP_0), U3001.J7 (DXN_0), U3001.J8 (DXP_0), U3002.4 (VSS), U3002.9 (VSS), U3003.2 (DIR1), U3003.8 (GND), U3003.9 (~OE), U3003.10 (DIR3), U3003.15 (DIR2), U3003.17 (EP); also elsewhere on the board
unnamed: D3001.2 (A), R3011.2
unnamed: D3002.2 (A), R3012.2
unnamed: J3001.2, R3014.2, U3003.14 (B1)
unnamed: J3001.3, U3003.13 (B2)
unnamed: J3001.4, R3015.2, U3003.12 (B3)
unnamed: J3001.5, U3003.11 (B4)
RELAY_A: U3001.J1 (IO_L15N_T2_DQS_34); also elsewhere on the board
RELAY_B: U3001.H2 (IO_L14P_T2_SRCC_34); also elsewhere on the board
RS485-D: U3001.J2 (IO_L15P_T2_DQS_34); also elsewhere on the board
RS485-DE: U3001.L1 (IO_L18N_T2_34); also elsewhere on the board
RS485-R: U3001.M1 (IO_L18P_T2_34); also elsewhere on the board
RS485-RE: U3001.L2 (IO_L22N_T3_34); also elsewhere on the board
UVLO: U3001.H13 (IO_L14P_T2_SRCC_14); also elsewhere on the board
ZCS_DETECT: U3001.K12 (IO_L19N_T3_D25_VREF_14); also elsewhere on the board

Notes on the sheet:
Configuration Info in UG470, Table 2-4 Schematic Figure 2-12

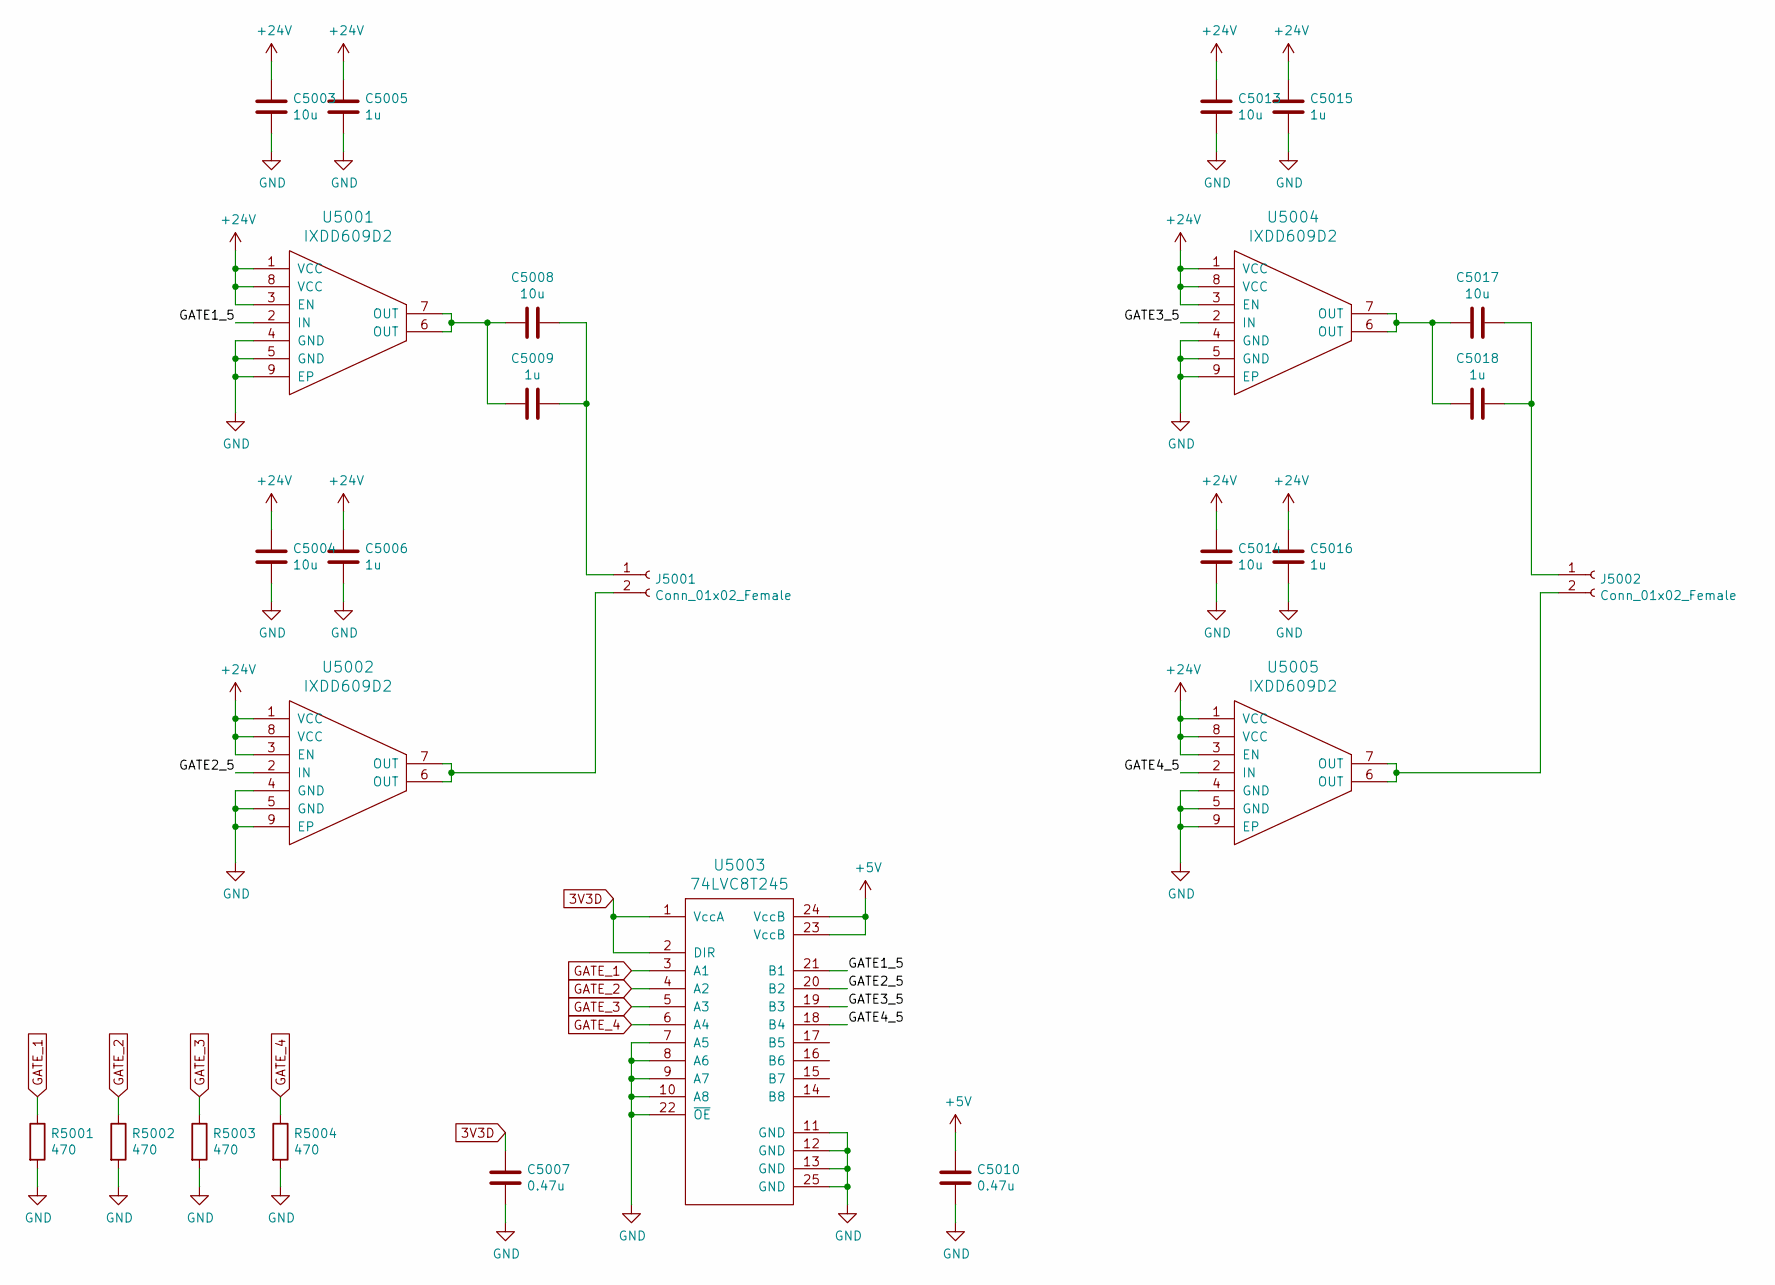
[picture p14: schematic GateDrive.sch]

Parts:
C5003, C5004, C5013, C5014, C5017: 10u; C_1206_3216Metric
C5005, C5006, C5009, C5015, C5016: 1u; C_0805_2012Metric
C5007, C5010: 0.47u; C_0402_1005Metric
C5008: 10u; C_0805_2012Metric
C5018: 1u; C_1206_3216Metric
J5001, J5002: Conn_01x02_Female; Terminal-block-plug_2x1_3.5mm-pitch
R5001, R5002, R5003, R5004: 470; R_0402_1005Metric
U5001, U5002, U5004, U5005: IXDD609D2; DFN-8_5x4mm_P0.95mm
U5003: 74LVC8T245; DHVQFN24_3.5x5.5mm_P0.5mm

Connections:
3V3D: C5007.1, U5003.1 (VccA), U5003.2 (DIR)
+5V: C5010.1, U5003.23 (VccB), U5003.24 (VccB); also elsewhere on the board
+24V: C5003.1, C5004.1, C5005.1, C5006.1, C5013.1, C5014.1, C5015.1, C5016.1, U5001.1 (VCC), U5001.3 (EN), U5001.8 (VCC), U5002.1 (VCC), U5002.3 (EN), U5002.8 (VCC), U5004.1 (VCC), U5004.3 (EN), U5004.8 (VCC), U5005.1 (VCC), U5005.3 (EN), U5005.8 (VCC); also elsewhere on the board
/Gate Drive/GATE1_5: U5001.2 (IN), U5003.21 (B1)
/Gate Drive/GATE2_5: U5002.2 (IN), U5003.20 (B2)
/Gate Drive/GATE3_5: U5003.19 (B3), U5004.2 (IN)
/Gate Drive/GATE4_5: U5003.18 (B4), U5005.2 (IN)
GATE_1: R5001.1, U5003.3 (A1); also elsewhere on the board
GATE_2: R5002.1, U5003.4 (A2); also elsewhere on the board
GATE_3: R5003.1, U5003.5 (A3); also elsewhere on the board
GATE_4: R5004.1, U5003.6 (A4); also elsewhere on the board
GND: C5003.2, C5004.2, C5005.2, C5006.2, C5007.2, C5010.2, C5013.2, C5014.2, C5015.2, C5016.2, R5001.2, R5002.2, R5003.2, R5004.2, U5001.4 (GND), U5001.5 (GND), U5001.9 (EP), U5002.4 (GND), U5002.5 (GND), U5002.9 (EP), U5003.7 (A5), U5003.8 (A6), U5003.9 (A7), U5003.10 (A8), U5003.11 (GND), U5003.12 (GND), U5003.13 (GND), U5003.22 (~OE), U5003.25 (GND), U5004.4 (GND), U5004.5 (GND), U5004.9 (EP), U5005.4 (GND), U5005.5 (GND), U5005.9 (EP); also elsewhere on the board
unnamed: C5008.1, C5009.1, J5001.1
unnamed: C5008.2, C5009.2, U5001.6 (OUT), U5001.7 (OUT)
unnamed: C5017.1, C5018.1, J5002.1
unnamed: C5017.2, C5018.2, U5004.6 (OUT), U5004.7 (OUT)
unnamed: J5001.2, U5002.6 (OUT), U5002.7 (OUT)
unnamed: J5002.2, U5005.6 (OUT), U5005.7 (OUT)

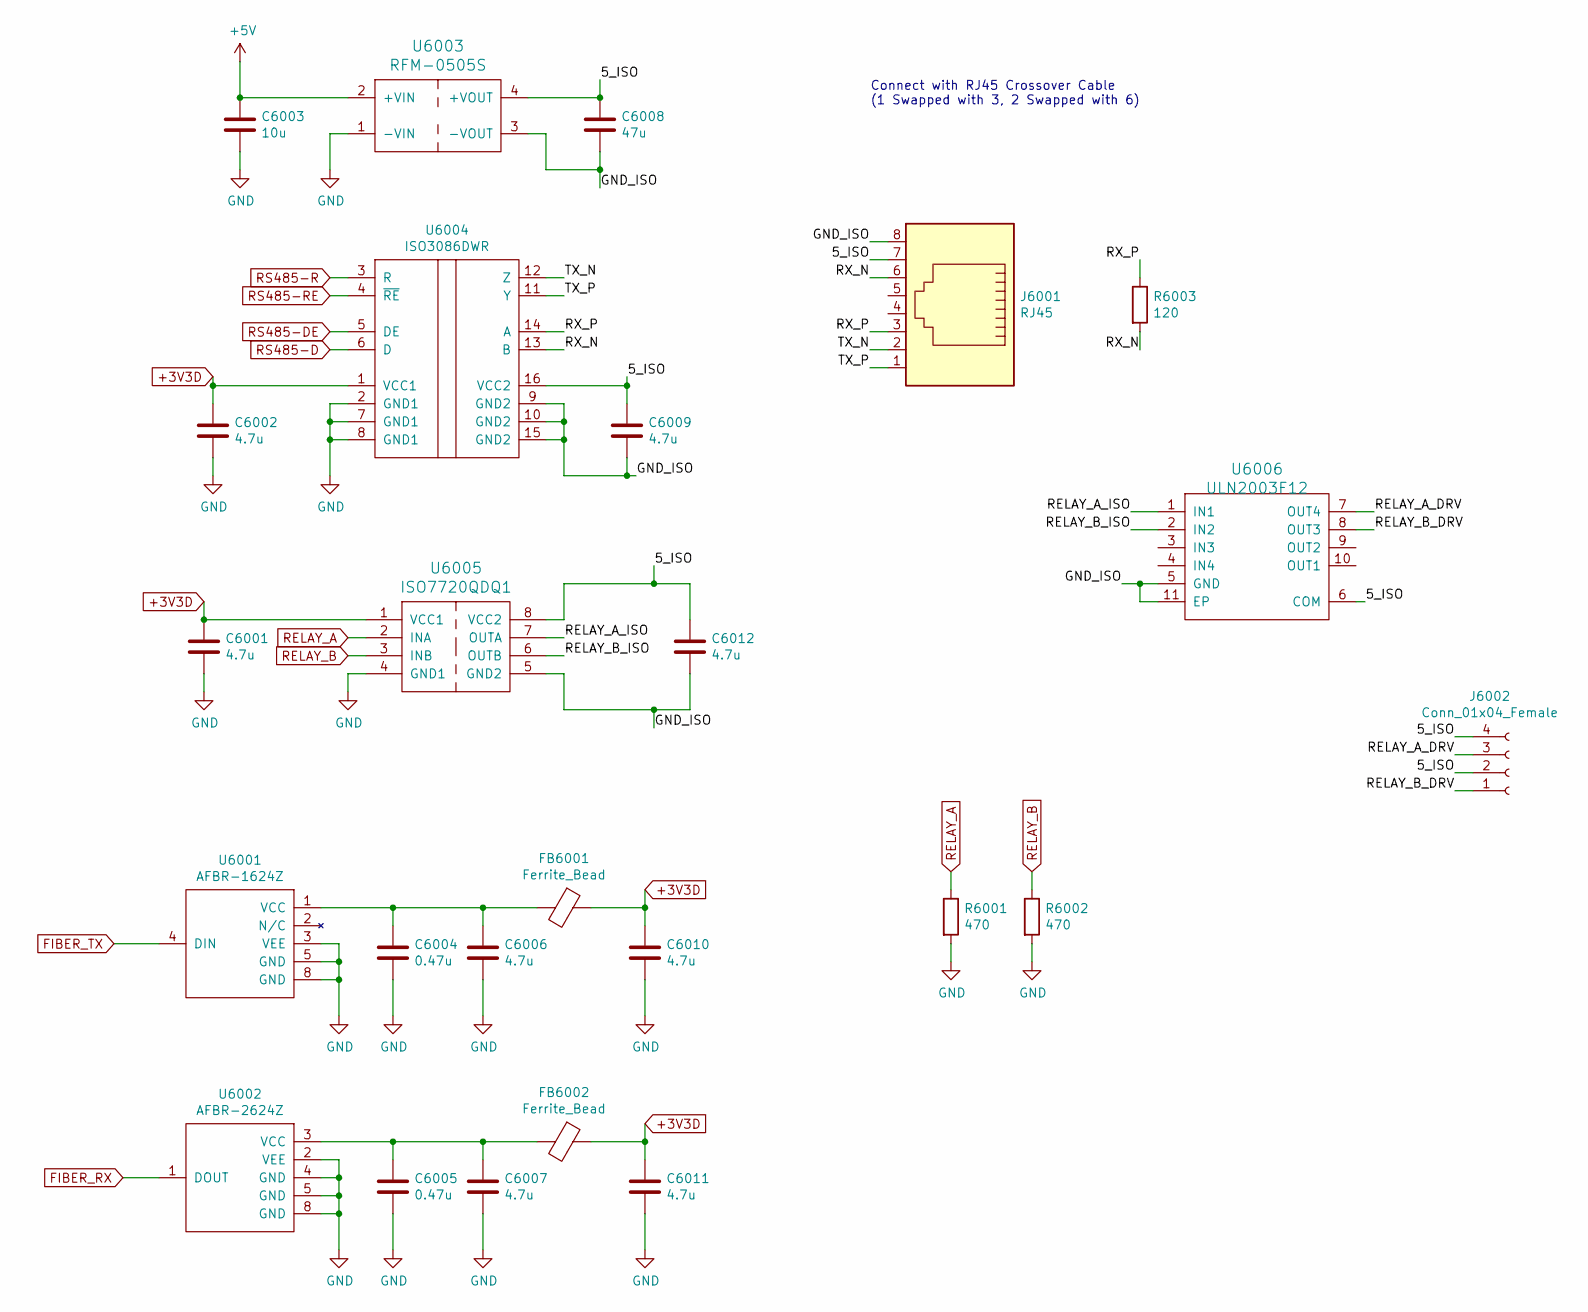
[picture p15: schematic Interface.sch]

Parts:
C6001, C6002, C6006, C6007, C6009, C6010, C6011, C6012: 4.7u; C_0402_1005Metric
C6003: 10u; C_0805_2012Metric
C6004, C6005: 0.47u; C_0402_1005Metric
C6008: 47u; C_0805_2012Metric
FB6001, FB6002: Ferrite_Bead; L_0805_2012Metric
J6001: RJ45; RJ45_Amphenol_54602-x08_Horizontal
J6002: Conn_01x04_Female; Terminal-block-plug_4x1_3.5mm-pitch
R6001, R6002: 470; R_0402_1005Metric
R6003: 120; R_1206_3216Metric
U6001: AFBR-1624Z; versatile-link_horizontal
U6002: AFBR-2624Z; versatile-link_horizontal
U6003: RFM-0505S
U6004: ISO3086DWR; SOIC-16W_7.5x10.3mm_P1.27mm
U6005: ISO7720QDQ1; SOIC-8_3.9x4.9mm_P1.27mm
U6006: ULN2003F12; DFN-10-1EP_3x3mm_P0.5mm_EP1.55x2.48mm

Connections:
+3V3D: C6001.1, C6002.1, C6010.1, C6011.1, FB6001.1, FB6002.1, U6004.1 (VCC1), U6005.1 (VCC1); also elsewhere on the board
+5V: C6003.1, U6003.2 (+VIN); also elsewhere on the board
/Interface/5_ISO: C6008.1, C6009.1, C6012.1, J6001.7, J6002.2, J6002.4, U6003.4 (+VOUT), U6004.16 (VCC2), U6005.8 (VCC2), U6006.6 (COM)
/Interface/GND_ISO: C6008.2, C6009.2, C6012.2, J6001.8, U6003.3 (-VOUT), U6004.9 (GND2), U6004.10 (GND2), U6004.15 (GND2), U6005.5 (GND2), U6006.5 (GND), U6006.11 (EP)
/Interface/RELAY_A_DRV: J6002.3, U6006.7 (OUT4)
/Interface/RELAY_A_ISO: U6005.7 (OUTA), U6006.1 (IN1)
/Interface/RELAY_B_DRV: J6002.1, U6006.8 (OUT3)
/Interface/RELAY_B_ISO: U6005.6 (OUTB), U6006.2 (IN2)
/Interface/RX_N: J6001.6, R6003.2, U6004.13 (B)
/Interface/RX_P: J6001.3, R6003.1, U6004.14 (A)
/Interface/TX_N: J6001.2, U6004.12 (Z)
/Interface/TX_P: J6001.1, U6004.11 (Y)
FIBER_RX: U6002.1 (DOUT); also elsewhere on the board
FIBER_TX: U6001.4 (DIN); also elsewhere on the board
GND: C6001.2, C6002.2, C6003.2, C6004.2, C6005.2, C6006.2, C6007.2, C6010.2, C6011.2, R6001.2, R6002.2, U6001.3 (VEE), U6001.5 (GND), U6001.8 (GND), U6002.2 (VEE), U6002.4 (GND), U6002.5 (GND), U6002.8 (GND), U6003.1 (-VIN), U6004.2 (GND1), U6004.7 (GND1), U6004.8 (GND1), U6005.4 (GND1); also elsewhere on the board
unnamed: C6004.1, C6006.1, FB6001.2, U6001.1 (VCC)
unnamed: C6005.1, C6007.1, FB6002.2, U6002.3 (VCC)
RELAY_A: R6001.1, U6005.2 (INA); also elsewhere on the board
RELAY_B: R6002.1, U6005.3 (INB); also elsewhere on the board
RS485-D: U6004.6 (D); also elsewhere on the board
RS485-DE: U6004.5 (DE); also elsewhere on the board
RS485-R: U6004.3 (R); also elsewhere on the board
RS485-RE: U6004.4 (~RE); also elsewhere on the board

Notes on the sheet:
Connect with RJ45 Crossover Cable (1 Swapped with 3, 2 Swapped with 6)

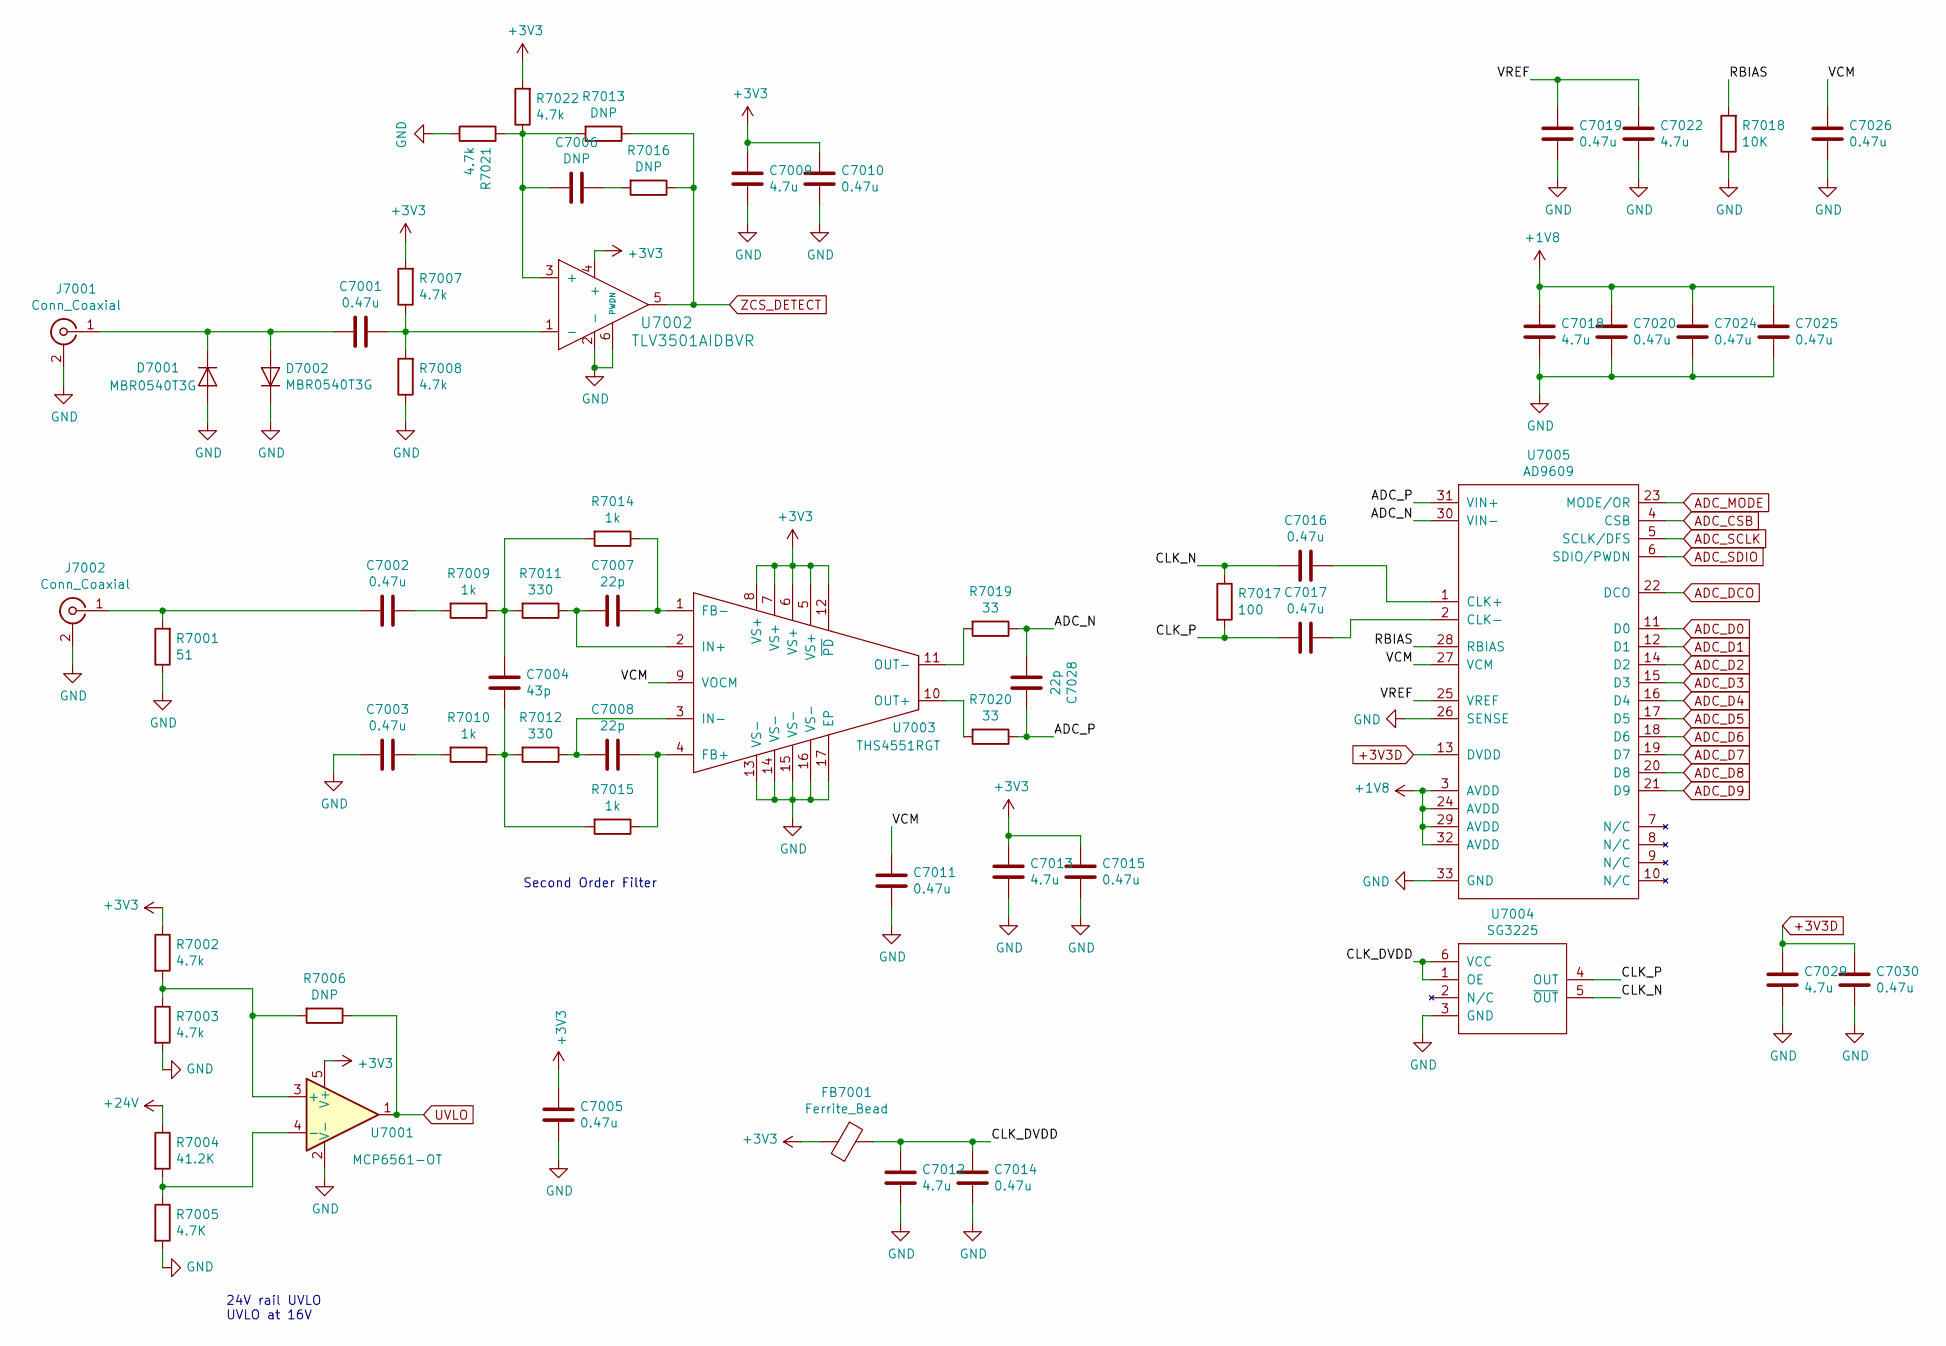
[picture p16: schematic Analog.sch]

Parts:
C7001, C7002, C7003, C7005, C7010, C7011, C7014, C7015, C7016, C7017, C7019, C7020, C7024, C7025, C7026, C7030: 0.47u; C_0402_1005Metric
C7004: 43p; C_0402_1005Metric
C7006: DNP; C_0402_1005Metric
C7007, C7008, C7028: 22p; C_0402_1005Metric
C7009, C7012, C7013, C7018, C7022, C7029: 4.7u; C_0402_1005Metric
D7001, D7002: MBR0540T3G; D_SOD-123
FB7001: Ferrite_Bead; L_0805_2012Metric
J7001, J7002: Conn_Coaxial; SMA_Amphenol_132134-16_Vertical
R7001: 51; R_2512_6332Metric
R7002, R7003, R7007, R7008, R7021, R7022: 4.7k; R_0402_1005Metric
R7004: 41.2K; R_0402_1005Metric
R7005: 4.7K; R_0402_1005Metric
R7006, R7013, R7016: DNP; R_0402_1005Metric
R7009, R7010, R7014, R7015: 1k; R_0402_1005Metric
R7011, R7012: 330; R_0402_1005Metric
R7017: 100; R_0402_1005Metric
R7018: 10K; R_0402_1005Metric
R7019, R7020: 33; R_0402_1005Metric
U7001: MCP6561-OT; SOT-23-5
U7002: TLV3501AIDBVR; SOT-23-6
U7003: THS4551RGT; QFN-16-1EP_3x3mm_P0.5mm_EP1.8x1.8mm
U7004: SG3225
U7005: AD9609; QFN-32-1EP_5x5mm_P0.5mm_EP3.45x3.45mm

Connections:
+1V8: C7018.2, C7020.2, C7024.2, C7025.2, U7005.3 (AVDD), U7005.24 (AVDD), U7005.29 (AVDD), U7005.32 (AVDD); also elsewhere on the board
+3V3: C7005.1, C7009.2, C7010.2, C7013.2, C7015.2, FB7001.2, R7002.1, R7007.2, R7022.2, U7001.5 (V+), U7002.4 (+), U7003.5 (VS+), U7003.6 (VS+), U7003.7 (VS+), U7003.8 (VS+), U7003.12 (~PD); also elsewhere on the board
+3V3D: C7029.2, C7030.2, U7005.13 (DVDD); also elsewhere on the board
+24V: R7004.1; also elsewhere on the board
/Analog/ADC_N: C7028.2, R7019.1, U7005.30 (VIN-)
/Analog/ADC_P: C7028.1, R7020.1, U7005.31 (VIN+)
/Analog/CLK_DVDD: C7012.2, C7014.2, FB7001.1, U7004.1 (OE), U7004.6 (VCC)
/Analog/CLK_N: C7016.1, R7017.1, U7004.5 (~OUT)
/Analog/CLK_P: C7017.1, R7017.2, U7004.4 (OUT)
/Analog/RBIAS: R7018.2, U7005.28 (RBIAS)
/Analog/VCM: C7011.2, C7026.2, U7003.9 (VOCM), U7005.27 (VCM)
/Analog/VREF: C7019.2, C7022.2, U7005.25 (VREF)
ADC_CSB: U7005.4 (CSB); also elsewhere on the board
ADC_D0: U7005.11 (D0); also elsewhere on the board
ADC_D1: U7005.12 (D1); also elsewhere on the board
ADC_D2: U7005.14 (D2); also elsewhere on the board
ADC_D3: U7005.15 (D3); also elsewhere on the board
ADC_D4: U7005.16 (D4); also elsewhere on the board
ADC_D5: U7005.17 (D5); also elsewhere on the board
ADC_D6: U7005.18 (D6); also elsewhere on the board
ADC_D7: U7005.19 (D7); also elsewhere on the board
ADC_D8: U7005.20 (D8); also elsewhere on the board
ADC_D9: U7005.21 (D9); also elsewhere on the board
ADC_DCO: U7005.22 (DCO); also elsewhere on the board
ADC_MODE: U7005.23 (MODE/OR); also elsewhere on the board
ADC_SCLK: U7005.5 (SCLK/DFS); also elsewhere on the board
ADC_SDIO: U7005.6 (SDIO/PWDN); also elsewhere on the board
GND: C7003.2, C7005.2, C7009.1, C7010.1, C7011.1, C7012.1, C7013.1, C7014.1, C7015.1, C7018.1, C7019.1, C7020.1, C7022.1, C7024.1, C7025.1, C7026.1, C7029.1, C7030.1, D7001.2 (A), D7002.1 (K), J7001.2 (Ext), J7002.2 (Ext), R7001.1, R7003.2, R7005.2, R7008.1, R7018.1, R7021.1, U7001.2 (V-), U7002.2 (-), U7002.6 (PWDN), U7003.13 (VS-), U7003.14 (VS-), U7003.15 (VS-), U7003.16 (VS-), U7003.17 (EP), U7004.3 (GND), U7005.26 (SENSE), U7005.33 (GND); also elsewhere on the board
unnamed: C7001.1, R7007.1, R7008.2, U7002.1 (-)
unnamed: C7001.2, D7001.1 (K), D7002.2 (A), J7001.1 (In)
unnamed: C7002.1, R7009.2
unnamed: C7002.2, J7002.1 (In), R7001.2
unnamed: C7003.1, R7010.2
unnamed: C7004.1, R7010.1, R7012.2, R7015.2
unnamed: C7004.2, R7009.1, R7011.2, R7014.2
unnamed: C7006.1, R7016.2
unnamed: C7006.2, R7013.2, R7021.2, R7022.1, U7002.3 (+)
unnamed: C7007.1, R7014.1, U7003.1 (FB-)
unnamed: C7007.2, R7011.1, U7003.2 (IN+)
unnamed: C7008.1, R7015.1, U7003.4 (FB+)
unnamed: C7008.2, R7012.1, U7003.3 (IN-)
unnamed: C7016.2, U7005.1 (CLK+)
unnamed: C7017.2, U7005.2 (CLK-)
unnamed: R7002.2, R7003.1, R7006.2, U7001.3 (+)
unnamed: R7004.2, R7005.1, U7001.4 (-)
unnamed: R7019.2, U7003.11 (OUT-)
unnamed: R7020.2, U7003.10 (OUT+)
UVLO: R7006.1, U7001.1; also elsewhere on the board
ZCS_DETECT: R7013.1, R7016.1, U7002.5; also elsewhere on the board

Notes on the sheet:
24V rail UVLO UVLO at 16V
Second Order Filter
