westonb/cute-qcw/pcb/controller/controller.kicad_pcb

## KiCad design pcb/controller/controller.kicad_pcb (continued)

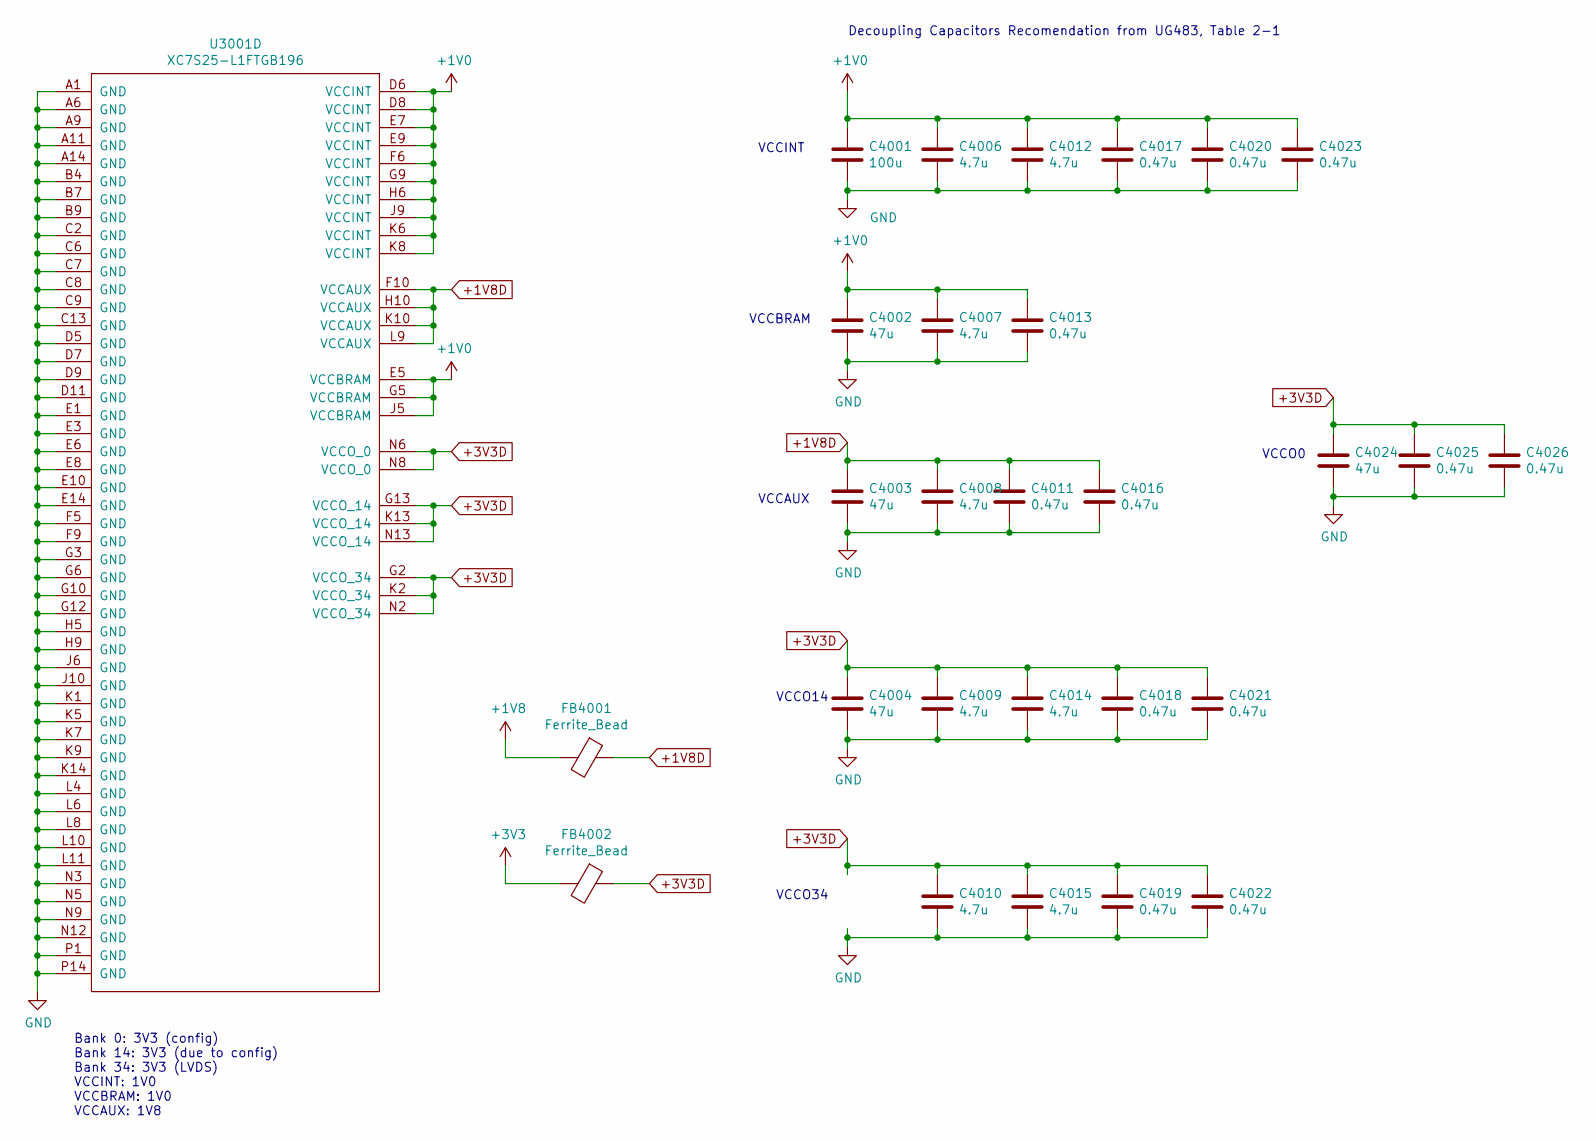
[picture p17: schematic FPGA_Power.sch]

Parts:
C4001: 100u; C_0805_2012Metric
C4002, C4003, C4004, C4024: 47u; C_0805_2012Metric
C4006, C4007, C4008, C4009, C4010, C4012, C4014, C4015: 4.7u; C_0402_1005Metric
C4011, C4013, C4016, C4017, C4018, C4019, C4020, C4021, C4022, C4023, C4025, C4026: 0.47u; C_0402_1005Metric
FB4001, FB4002: Ferrite_Bead; L_0805_2012Metric
U3001: XC7S25-L1FTGB196; FTGB196

Connections:
+1V0: C4001.1, C4002.1, C4006.1, C4007.1, C4012.1, C4013.1, C4017.1, C4020.1, C4023.1, U3001.D6 (VCCINT), U3001.D8 (VCCINT), U3001.E5 (VCCBRAM), U3001.E7 (VCCINT), U3001.E9 (VCCINT), U3001.F6 (VCCINT), U3001.G5 (VCCBRAM), U3001.G9 (VCCINT), U3001.H6 (VCCINT), U3001.J5 (VCCBRAM), U3001.J9 (VCCINT), U3001.K6 (VCCINT), U3001.K8 (VCCINT); also elsewhere on the board
+1V8: FB4001.2; also elsewhere on the board
+1V8D: C4003.1, C4008.1, C4011.1, C4016.1, FB4001.1, U3001.F10 (VCCAUX), U3001.H10 (VCCAUX), U3001.K10 (VCCAUX), U3001.L9 (VCCAUX); also elsewhere on the board
+3V3: FB4002.2; also elsewhere on the board
+3V3D: C4004.1, C4009.1, C4010.1, C4014.1, C4015.1, C4018.1, C4019.1, C4021.1, C4022.1, C4024.1, C4025.1, C4026.1, FB4002.1, U3001.G2 (VCCO_34), U3001.G13 (VCCO_14), U3001.K2 (VCCO_34), U3001.K13 (VCCO_14), U3001.N2 (VCCO_34), U3001.N6 (VCCO_0), U3001.N8 (VCCO_0), U3001.N13 (VCCO_14); also elsewhere on the board
GND: C4001.2, C4002.2, C4003.2, C4004.2, C4006.2, C4007.2, C4008.2, C4009.2, C4010.2, C4011.2, C4012.2, C4013.2, C4014.2, C4015.2, C4016.2, C4017.2, C4018.2, C4019.2, C4020.2, C4021.2, C4022.2, C4023.2, C4024.2, C4025.2, C4026.2, U3001.A1 (GND), U3001.A6 (GND), U3001.A9 (GND), U3001.A11 (GND), U3001.A14 (GND), U3001.B4 (GND), U3001.B7 (GND), U3001.B9 (GND), U3001.C2 (GND), U3001.C6 (GND), U3001.C7 (GND), U3001.C8 (GND), U3001.C9 (GND), U3001.C13 (GND), U3001.D5 (GND), U3001.D7 (GND), U3001.D9 (GND), U3001.D11 (GND), U3001.E1 (GND), U3001.E3 (GND), U3001.E6 (GND), U3001.E8 (GND), U3001.E10 (GND), U3001.E14 (GND), U3001.F5 (GND), U3001.F9 (GND), U3001.G3 (GND), U3001.G6 (GND), U3001.G10 (GND), U3001.G12 (GND), U3001.H5 (GND), U3001.H9 (GND), U3001.J6 (GND), U3001.J10 (GND), U3001.K1 (GND), U3001.K5 (GND), U3001.K7 (GND), U3001.K9 (GND), U3001.K14 (GND), U3001.L4 (GND), U3001.L6 (GND), U3001.L8 (GND), U3001.L10 (GND), U3001.L11 (GND), U3001.N3 (GND), U3001.N5 (GND), U3001.N9 (GND), U3001.N12 (GND), U3001.P1 (GND), U3001.P14 (GND); also elsewhere on the board

Notes on the sheet:
Decoupling Capacitors Recomendation from UG483, Table 2-1
VCCINT
VCCBRAM
VCCAUX
VCCO14
Bank 0: 3V3 (config) Bank 14: 3V3 (due to config) Bank 34: 3V3 (LVDS) VCCINT: 1V0 VCCBRAM: 1V0 VCCAUX: 1V8
VCCO34
VCCO0

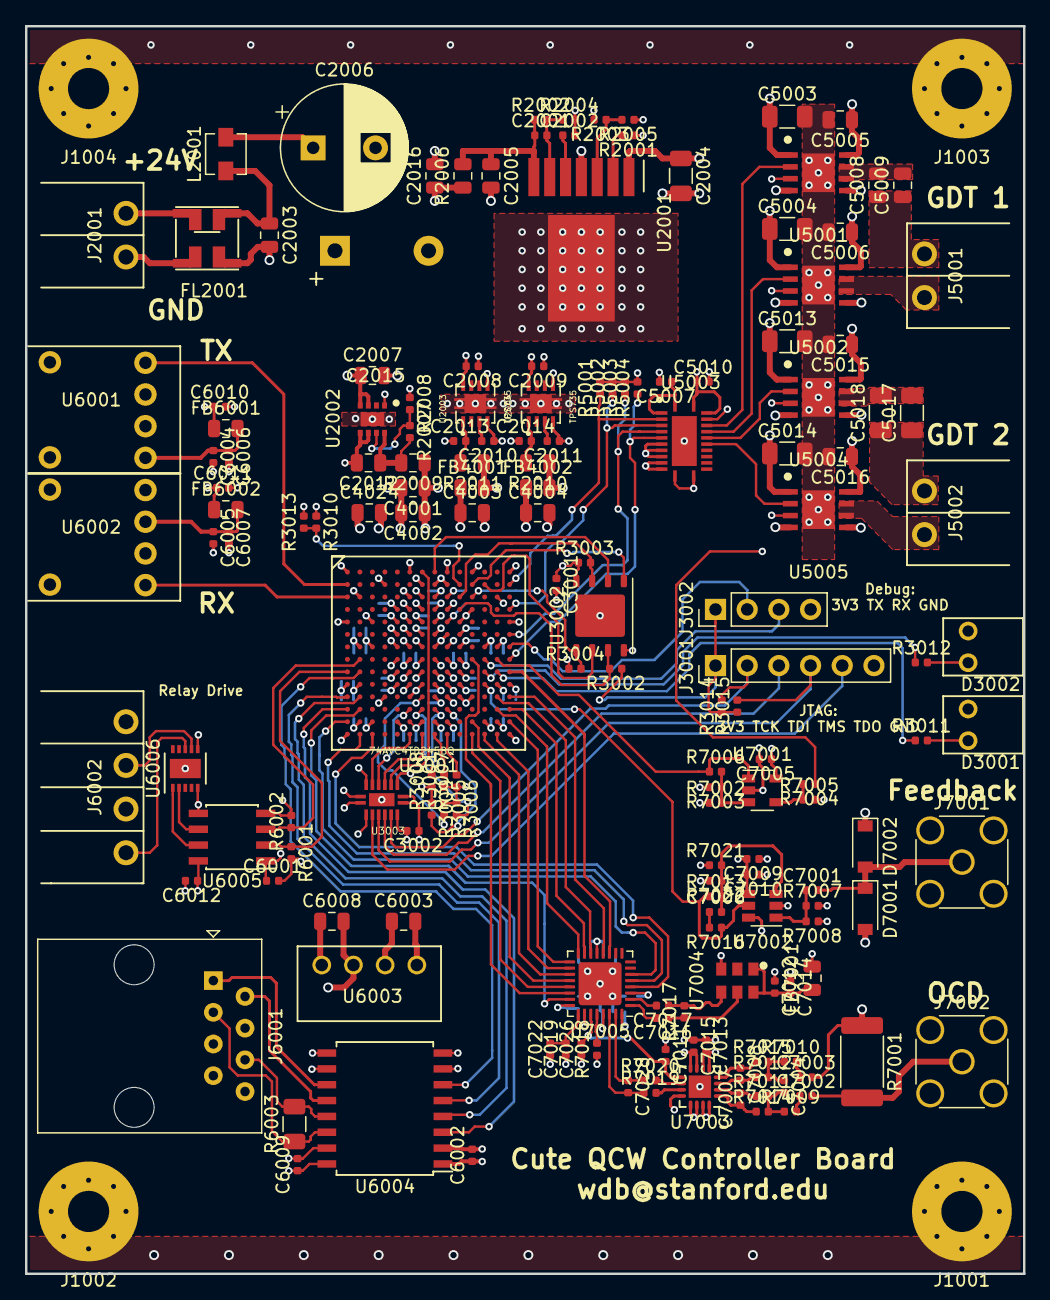
[picture p18: board controller.kicad_pcb from above]

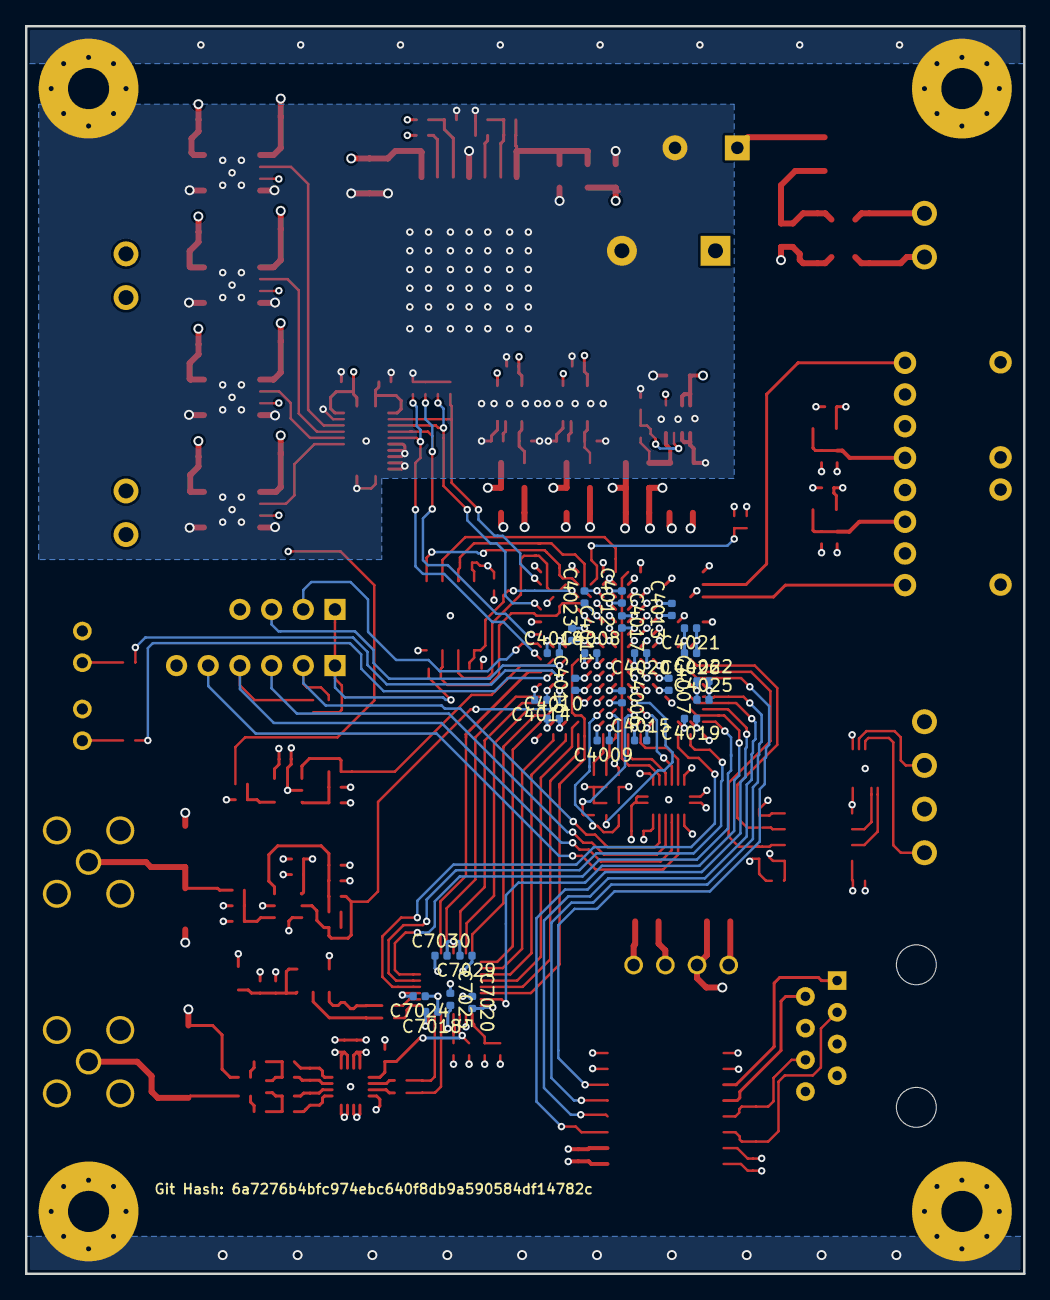
[picture p19: board controller.kicad_pcb from below]

Board: 4 copper layers, 80.0 x 100.0 mm, 198 parts (26 on the bottom side), 128 nets.
