westonb/cute-qcw/pcb/power/power/power.kicad_pcb

## KiCad design pcb/power/power/power.kicad_pcb (2019-01-25)

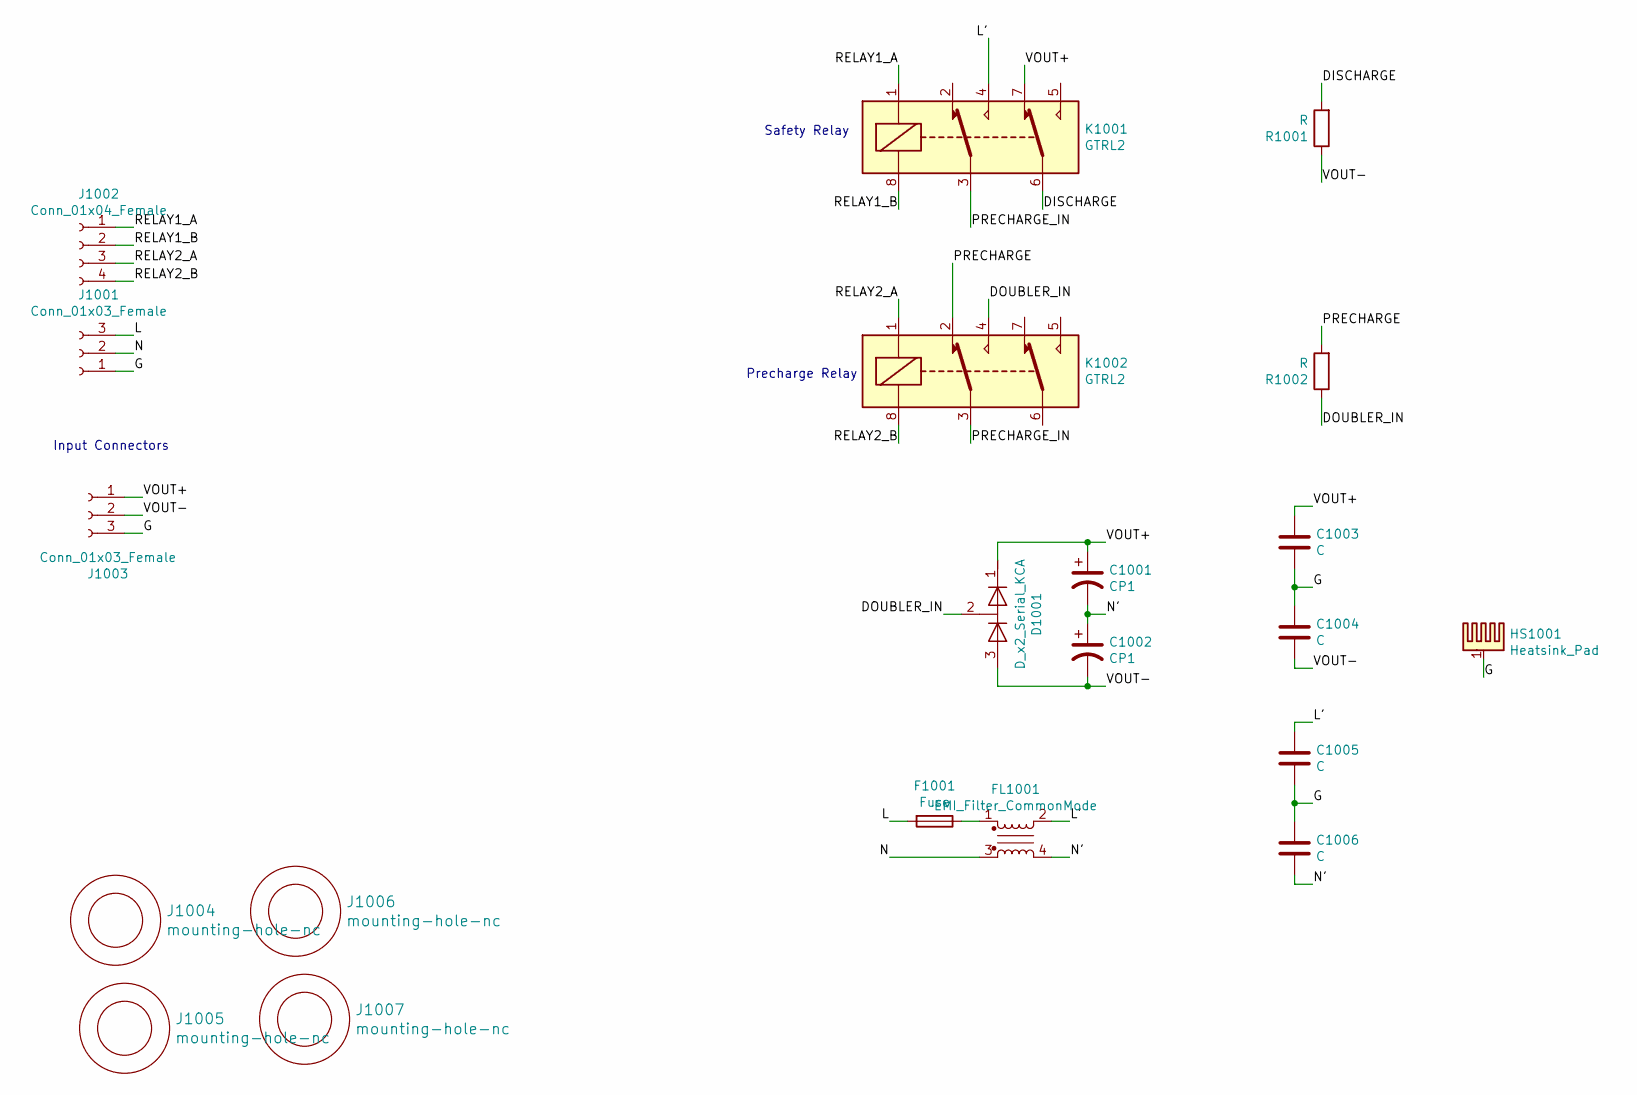
[picture p20: schematic power.sch]

Parts:
C1001, C1002: CP1; CP_Radial_D25.0mm_P10.00mm_SnapIn
C1003, C1004, C1005, C1006: C; C_Rect_L18.0mm_W8.0mm_P15.00mm_FKS3_FKP3
D1001: D_x2_Serial_KCA; TO-247-3_Vertical
F1001: Fuse; Fuseholder_Cylinder-5x20mm_Schurter_0031_8201_Horizontal_Op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
FL1001: EMI_Filter_CommonMode; 744824622
HS1001: Heatsink_Pad; RA-T2X
J1001, J1003: Conn_01x03_Female; Terminal-block-plug_3x1_5mm-pitch
J1002: Conn_01x04_Female; Terminal-block-plug_4x1_3.5mm-pitch
J1004, J1005, J1006, J1007: mounting-hole-nc; M3-mounting-hole-insulated
K1001, K1002: GTRL2; G2RL-2
R1001, R1002: R; RESISTOR_CW010

Connections:
/DISCHARGE: K1001.6, R1001.2
/DOUBLER_IN: D1001.2 (common), K1002.4, R1002.1
/G: C1003.2, C1004.1, C1005.2, C1006.1, HS1001.1, J1001.1, J1003.3
/L: F1001.2, J1001.3
/L': C1005.1, FL1001.2, K1001.4
/N: FL1001.3, J1001.2
/N': C1001.2, C1002.1, C1006.2, FL1001.4
/PRECHARGE: K1002.2, R1002.2
/PRECHARGE_IN: K1001.3, K1002.3
/RELAY1_A: J1002.1, K1001.1
/RELAY1_B: J1002.2, K1001.8
/RELAY2_A: J1002.3, K1002.1
/RELAY2_B: J1002.4, K1002.8
/VOUT+: C1001.1, C1003.1, D1001.1 (K), J1003.1, K1001.7
/VOUT-: C1002.2, C1004.2, D1001.3 (A), J1003.2, R1001.1
unnamed: F1001.1, FL1001.1

Notes on the sheet:
Safety Relay
Precharge Relay
Input Connectors

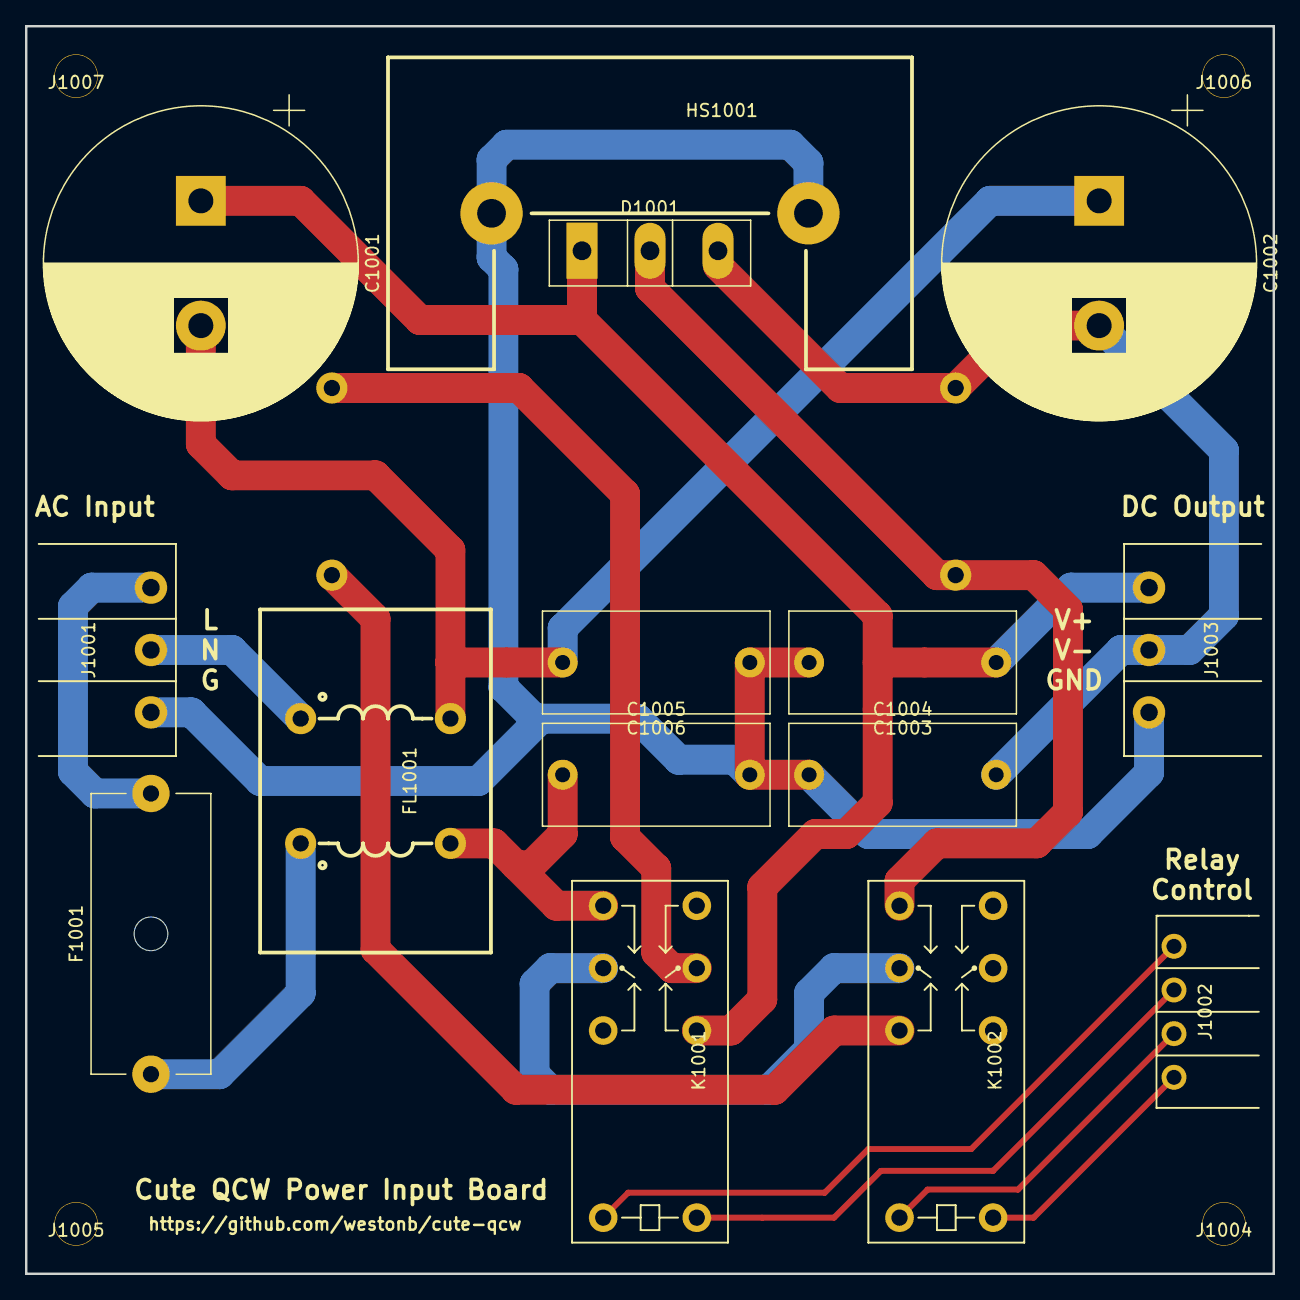
[picture p21: board power.kicad_pcb from above]

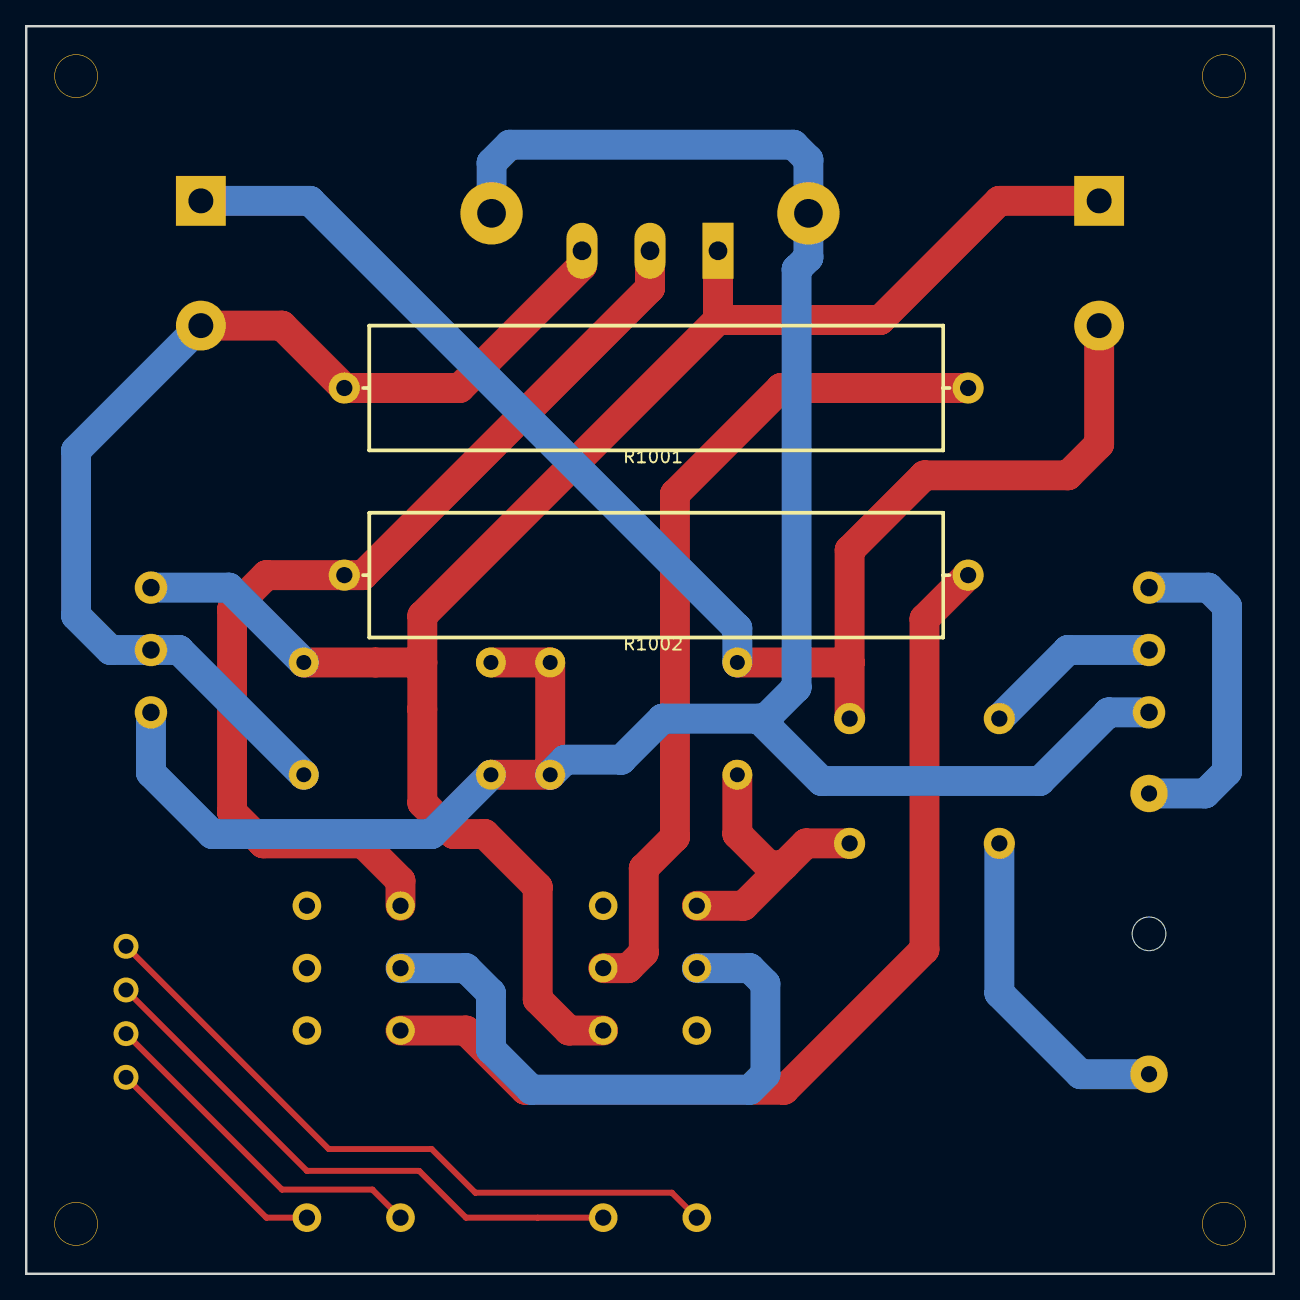
[picture p22: board power.kicad_pcb from below]

Board: 2 copper layers, 100.0 x 100.0 mm, 21 parts (2 on the bottom side), 16 nets.
