westonb/cute-qcw/pcb/mmc/mmc/mmc.kicad_pcb

## KiCad design pcb/mmc/mmc/mmc.kicad_pcb (2019-01-25)

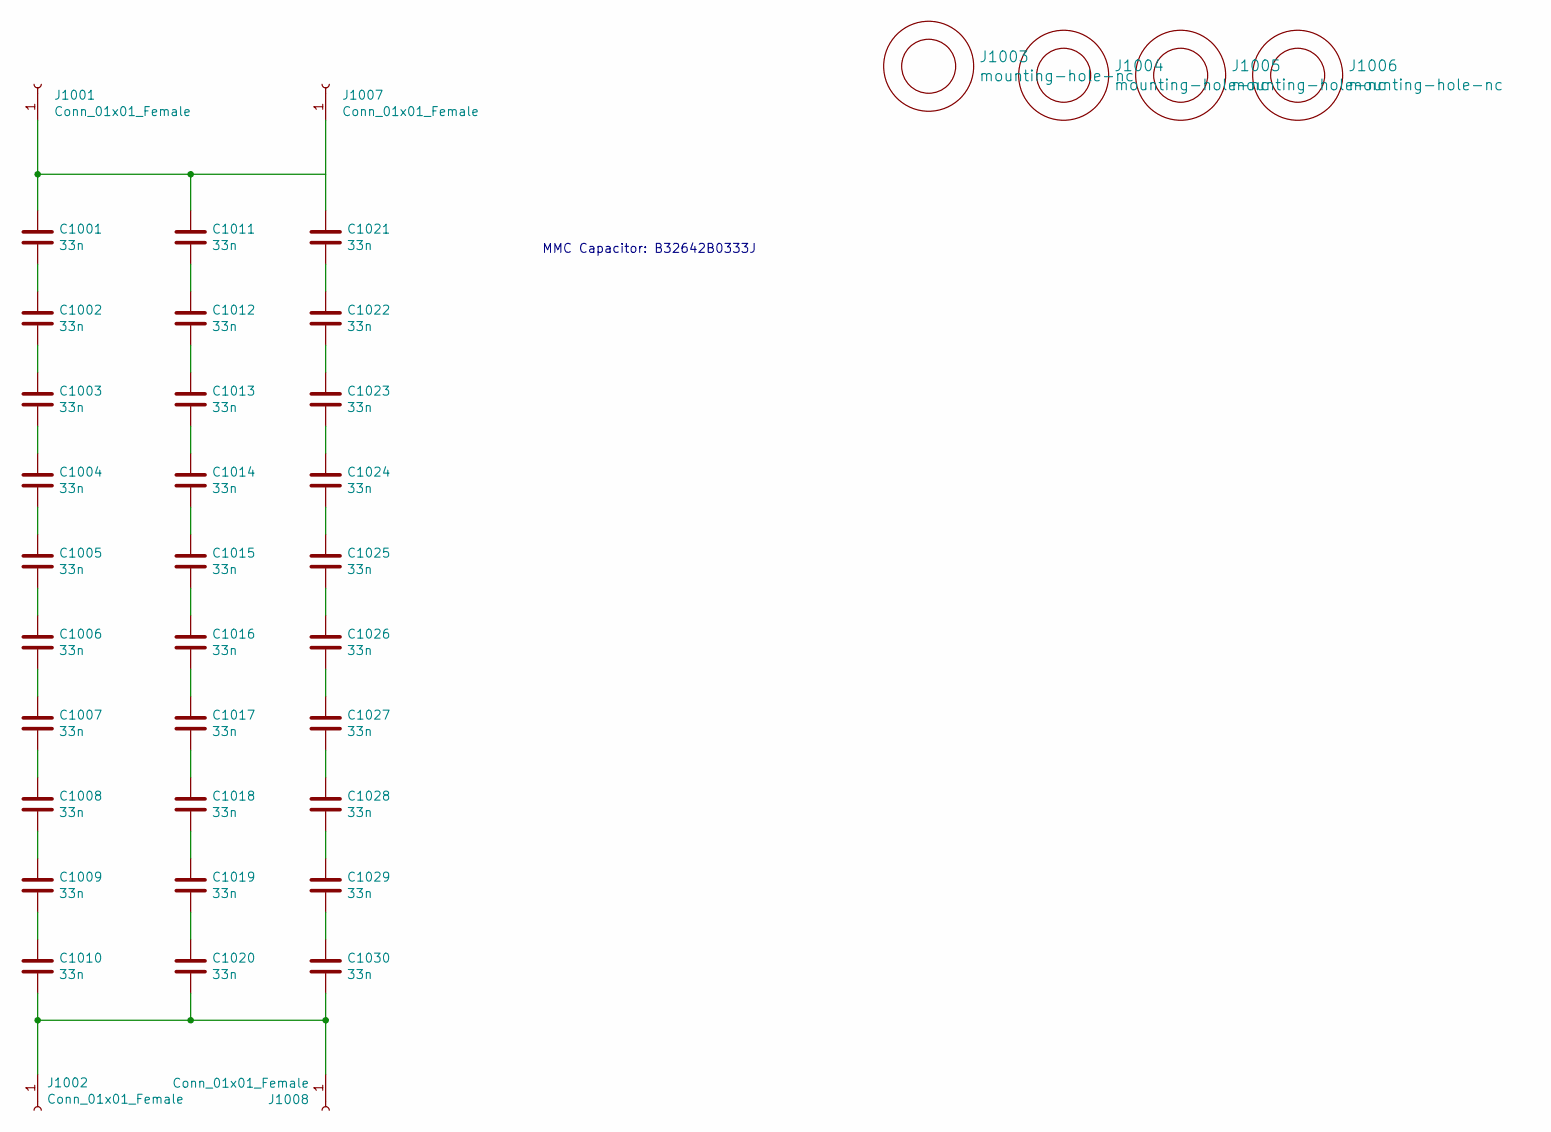
[picture p23: schematic mmc.sch]

Parts:
C1001, C1002, C1003, C1004, C1005, C1006, C1007, C1008, C1009, C1010, C1011, C1012, C1013, C1014, C1015, C1016, C1017, C1018, C1019, C1020, C1021, C1022, C1023, C1024, C1025, C1026, C1027, C1028, C1029, C1030: 33n; C_Rect_L18.0mm_W7.0mm_P15.00mm_FKS3_FKP3
J1001, J1002, J1007, J1008: Conn_01x01_Female; 7693-term
J1003, J1004, J1005, J1006: mounting-hole-nc; M3-mounting-hole-insulated

Connections:
unnamed: C1001.1, C1011.1, C1021.1, J1001.1, J1007.1
unnamed: C1001.2, C1002.1
unnamed: C1002.2, C1003.1
unnamed: C1003.2, C1004.1
unnamed: C1004.2, C1005.1
unnamed: C1005.2, C1006.1
unnamed: C1006.2, C1007.1
unnamed: C1007.2, C1008.1
unnamed: C1008.2, C1009.1
unnamed: C1009.2, C1010.1
unnamed: C1010.2, C1020.2, C1030.2, J1002.1, J1008.1
unnamed: C1011.2, C1012.1
unnamed: C1012.2, C1013.1
unnamed: C1013.2, C1014.1
unnamed: C1014.2, C1015.1
unnamed: C1015.2, C1016.1
unnamed: C1016.2, C1017.1
unnamed: C1017.2, C1018.1
unnamed: C1018.2, C1019.1
unnamed: C1019.2, C1020.1
unnamed: C1021.2, C1022.1
unnamed: C1022.2, C1023.1
unnamed: C1023.2, C1024.1
unnamed: C1024.2, C1025.1
unnamed: C1025.2, C1026.1
unnamed: C1026.2, C1027.1
unnamed: C1027.2, C1028.1
unnamed: C1028.2, C1029.1
unnamed: C1029.2, C1030.1

Notes on the sheet:
MMC Capacitor: B32642B0333J

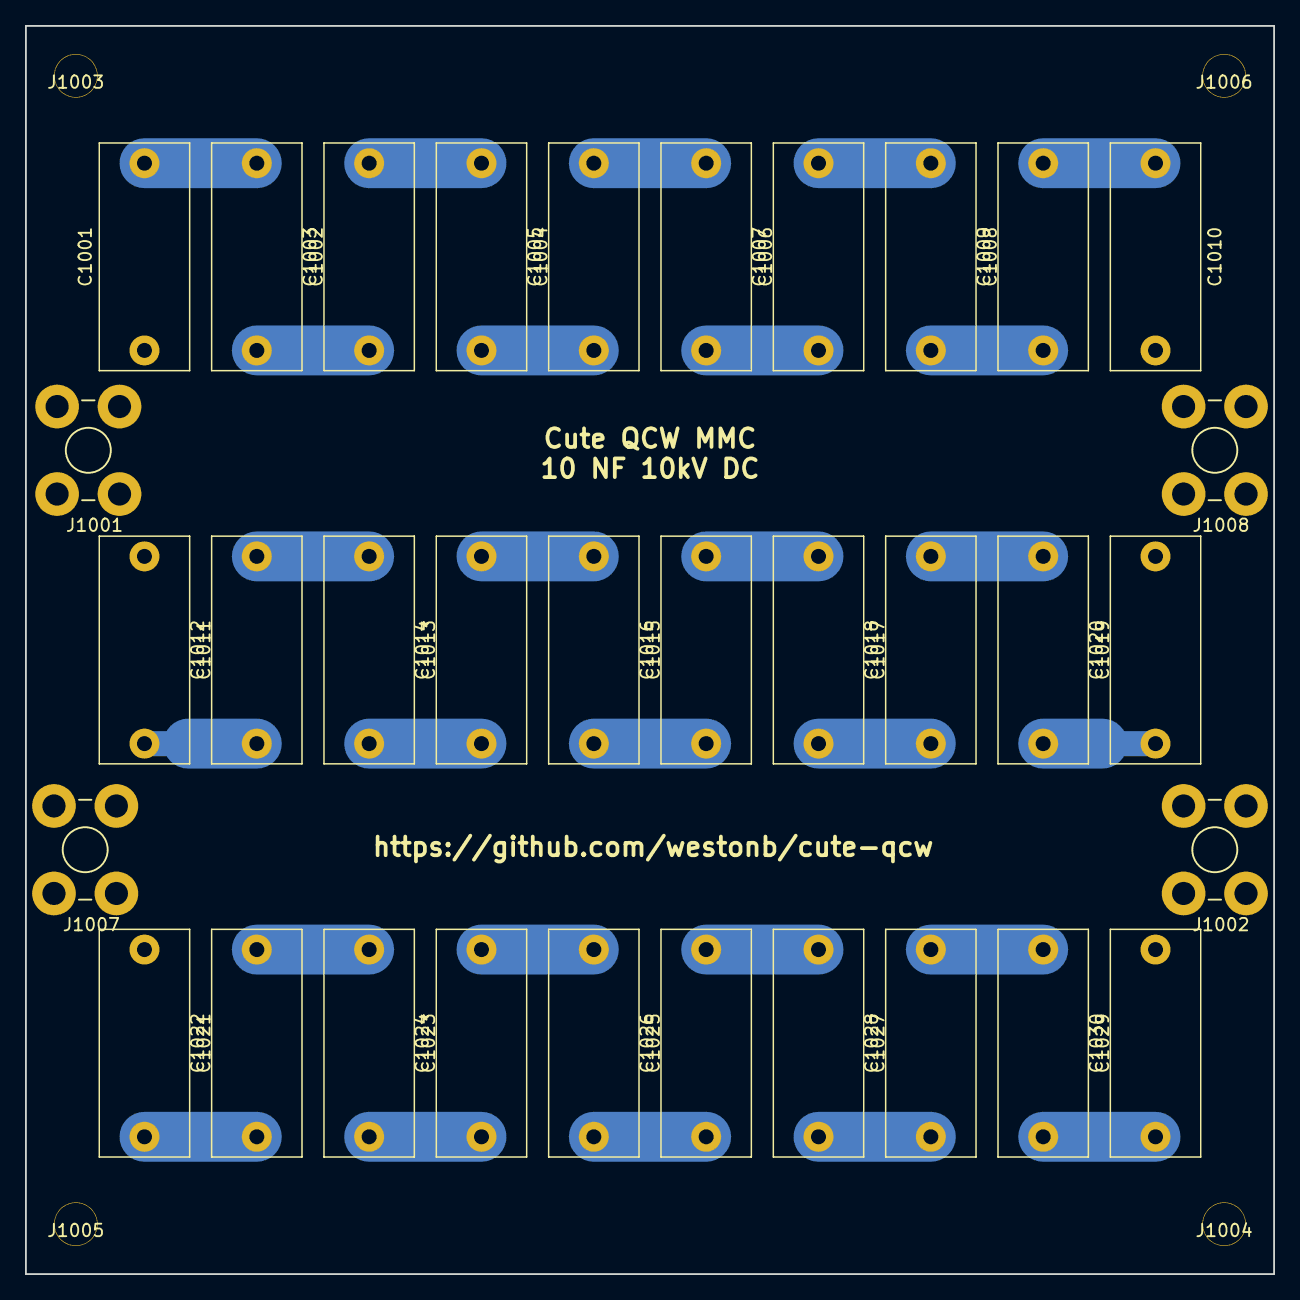
[picture p24: board mmc.kicad_pcb from above]

Board: 2 copper layers, 100.0 x 100.0 mm, 38 parts (0 on the bottom side), 29 nets.
