westonb/cute-qcw/pcb/inverter/inverter.kicad_pcb

## KiCad design pcb/inverter/inverter.kicad_pcb (2019-01-23)

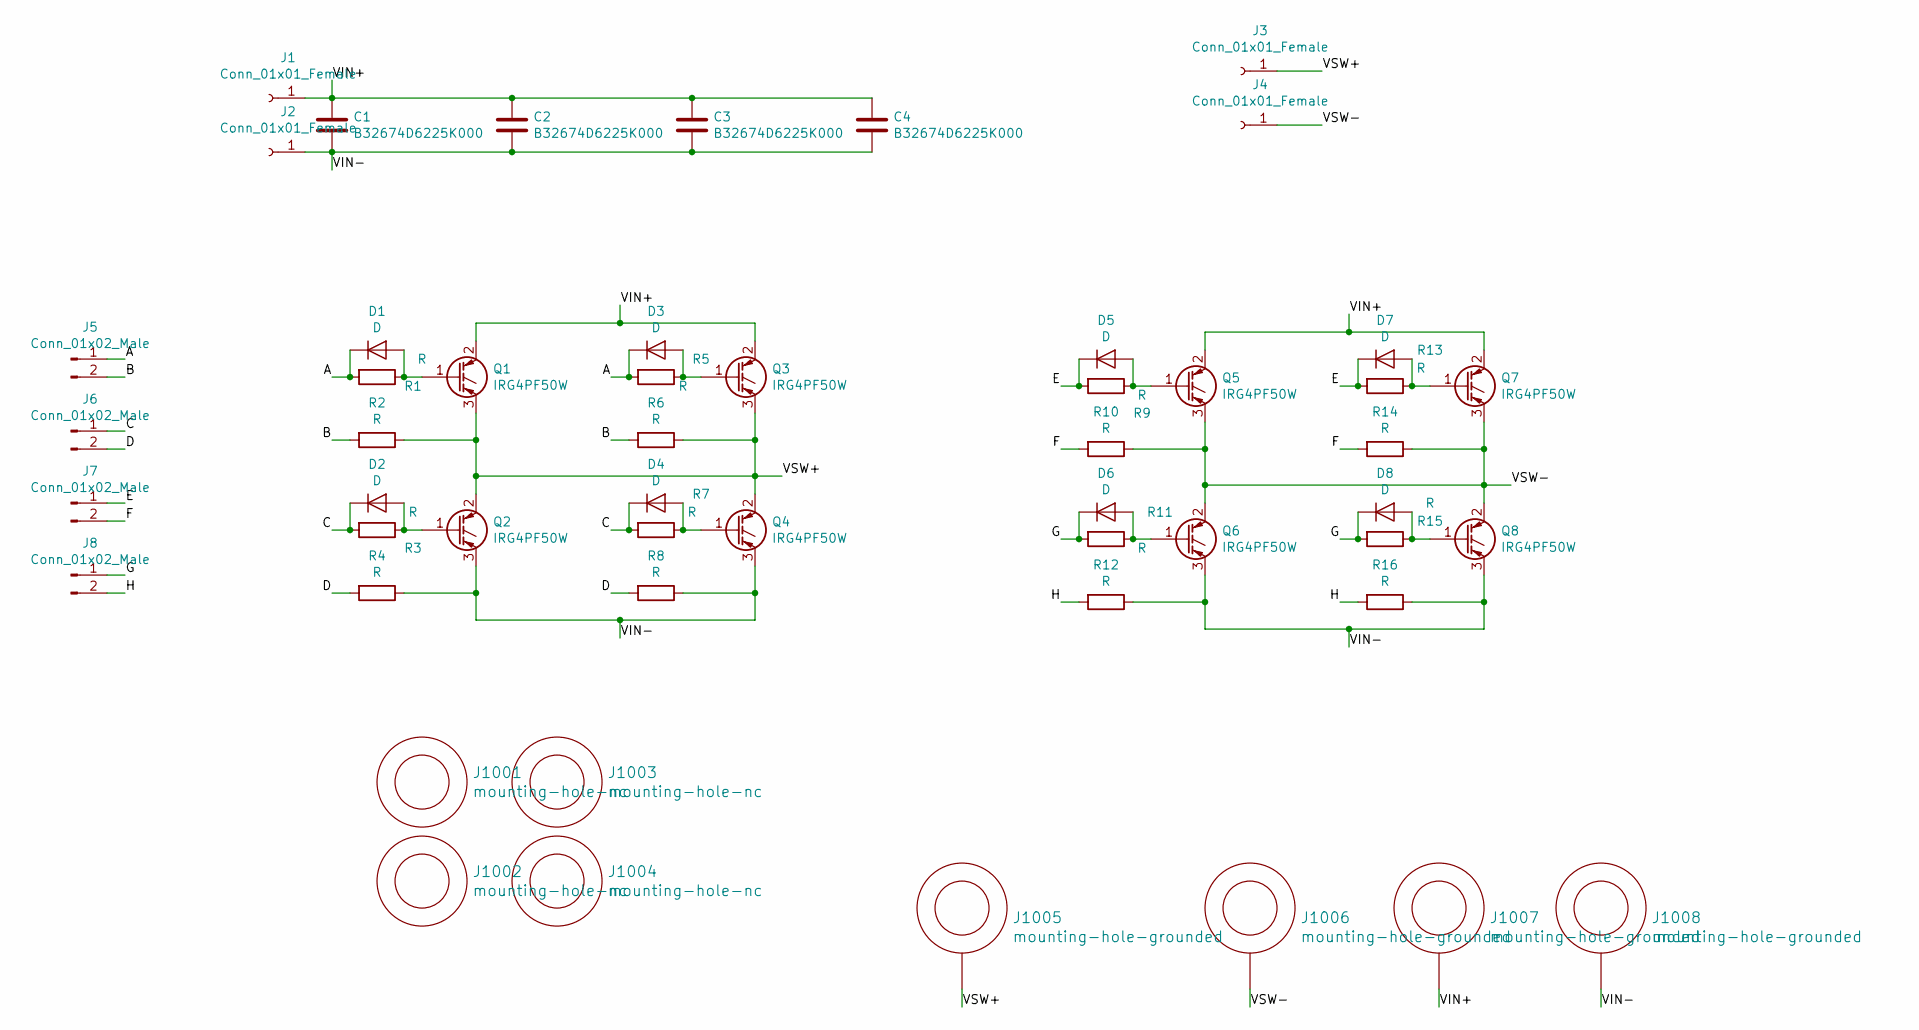
[picture p25: schematic inverter.sch]

Parts:
C1, C2, C3, C4: B32674D6225K000; C_Rect_L31.5mm_W17.0mm_P27.50mm_MKS4
D1, D2, D3, D4, D5, D6, D7, D8: D; D_SOD-123F
J1, J2, J3, J4: Conn_01x01_Female; 7693-term
J5, J6, J7, J8: Conn_01x02_Male; PinHeader_1x02_P2.54mm_Vertical
J1001, J1002, J1003, J1004: mounting-hole-nc; M3-through-hole
J1005, J1006, J1007, J1008: mounting-hole-grounded; M3-tight-fit-pan-head
Q1, Q2, Q3, Q4, Q5, Q6, Q7, Q8: IRG4PF50W; TO-247-3_Vertical
R1, R2, R3, R4, R5, R6, R7, R8, R9, R10, R11, R12, R13, R14, R15, R16: R; R_1206_3216Metric

Connections:
/A: D1.1 (K), D3.1 (K), J5.1, R1.2, R5.2
/B: J5.2, R2.2, R6.2
/C: D2.1 (K), D4.1 (K), J6.1, R3.2, R7.2
/D: J6.2, R4.2, R8.2
/E: D5.1 (K), D7.1 (K), J7.1, R9.2, R13.2
/F: J7.2, R10.2, R14.2
/G: D6.1 (K), D8.1 (K), J8.1, R11.2, R15.2
/H: J8.2, R12.2, R16.2
/VIN+: C1.1, C2.1, C3.1, C4.1, J1.1, J1007.1, Q1.2 (C), Q3.2 (C), Q5.2 (C), Q7.2 (C)
/VIN-: C1.2, C2.2, C3.2, C4.2, J2.1, J1008.1, Q2.3 (E), Q4.3 (E), Q6.3 (E), Q8.3 (E), R4.1, R8.1, R12.1, R16.1
/VSW+: J3.1, J1005.1, Q1.3 (E), Q2.2 (C), Q3.3 (E), Q4.2 (C), R2.1, R6.1
/VSW-: J4.1, J1006.1, Q5.3 (E), Q6.2 (C), Q7.3 (E), Q8.2 (C), R10.1, R14.1
unnamed: D1.2 (A), Q1.1 (G), R1.1
unnamed: D2.2 (A), Q2.1 (G), R3.1
unnamed: D3.2 (A), Q3.1 (G), R5.1
unnamed: D4.2 (A), Q4.1 (G), R7.1
unnamed: D5.2 (A), Q5.1 (G), R9.1
unnamed: D6.2 (A), Q6.1 (G), R11.1
unnamed: D7.2 (A), Q7.1 (G), R13.1
unnamed: D8.2 (A), Q8.1 (G), R15.1

Board: 2 copper layers, 52 parts (0 on the bottom side), 20 nets, no tracks yet.
