westonb/cute-qcw/(commit log)

2018-02-02 first schematic revision mostly done
    [analog.sch, controller.kicad_pcb, controller.sch, dsp.sch, gate_drive.sch, power.sch]
2018-10-26 finished inverter PCB layout
    [inverter.kicad_pcb, inverter.sch]
2019-01-17 started FPGA based controller design
    [Analog.sch, FPGA.sch, FPGA_Power.sch, GateDrive.sch, Interface.sch, Power.sch, analog.sch, controller.kicad_pcb]
2019-01-18 controller schematic capture almost done
    [Analog.sch, FPGA.sch, FPGA_Power.sch, GateDrive.sch, Interface.sch, Power.sch, controller.sch]
2019-01-19 started assigning footprints
    [Analog.sch, FPGA.sch, FPGA_Power.sch, GateDrive.sch, Interface.sch, Power.sch]
2019-01-20 pcb component placement almost done
    [Analog.sch, FPGA.sch, FPGA_Power.sch, GateDrive.sch, Interface.sch, Power.sch, controller.kicad_pcb, controller.sch]
2019-01-21 controller PCB routing progress
    [Analog.sch, FPGA.sch, GateDrive.sch, Interface.sch, Power.sch, controller.kicad_pcb]
2019-01-21 routing almost done
    [FPGA.sch, GateDrive.sch, Interface.sch, controller.kicad_pcb]
2019-01-22 controller layout done and schematic reviewed
    [FPGA.sch, Interface.sch, Power.sch, controller.kicad_pcb, controller.sch]
2019-01-22 generated gerbers
    [controller-B.Cu.gbr, controller-B.Mask.gbr, controller-B.SilkS.gbr, controller-Edge.Cuts.gbr, controller-F.Cu.gbr, controller-F.Mask.gbr, controller-F.SilkS.gbr, controller-In1.Cu.gbr]
2019-01-22 inverter PCB layout finished
    [inverter.kicad_pcb, inverter.sch]
2019-01-23 created inverter gerbers
    [inverter-B.Cu.gbr, inverter-B.Mask.gbr, inverter-B.SilkS.gbr, inverter-Edge.Cuts.gbr, inverter-F.Cu.gbr, inverter-F.Mask.gbr, inverter-F.SilkS.gbr, inverter.drl]
2019-01-23 created schematic for power input board
    [power.kicad_pcb, power.sch]
2019-01-23 started MMC PCB
    [mmc.kicad_pcb, mmc.sch]
2019-01-23 regenerated all gerbers and ordered controller and inverter pcbs
    [controller-B.Cu.gbr, controller-B.Mask.gbr, controller-B.SilkS.gbr, controller-Edge.Cuts.gbr, controller-F.Cu.gbr, controller-F.Mask.gbr, controller-F.SilkS.gbr, controller-In1.Cu.gbr]
2019-01-24 updated controller schematic
2019-01-25 finished power and MMC PCBs and created gerbers
    [mmc-B.Cu.gbr, mmc-B.Mask.gbr, mmc-B.SilkS.gbr, mmc-Edge.Cuts.gbr, mmc-F.Cu.gbr, mmc-F.Mask.gbr, mmc-F.SilkS.gbr, mmc-NPTH.drl]
2019-01-25 generated PDF schematics of all PCBs
2019-02-12 updated schematic component values
    [Analog.sch, FPGA.sch, GateDrive.sch, Interface.sch, Power.sch, controller.kicad_pcb, inverter.sch]
2019-02-12 added stencil files
    [controller.gko, controller.gtp]
